Milan2mecha/mereni_efektivity/dokumentace a blokova schemata/LM317-efektivita.png

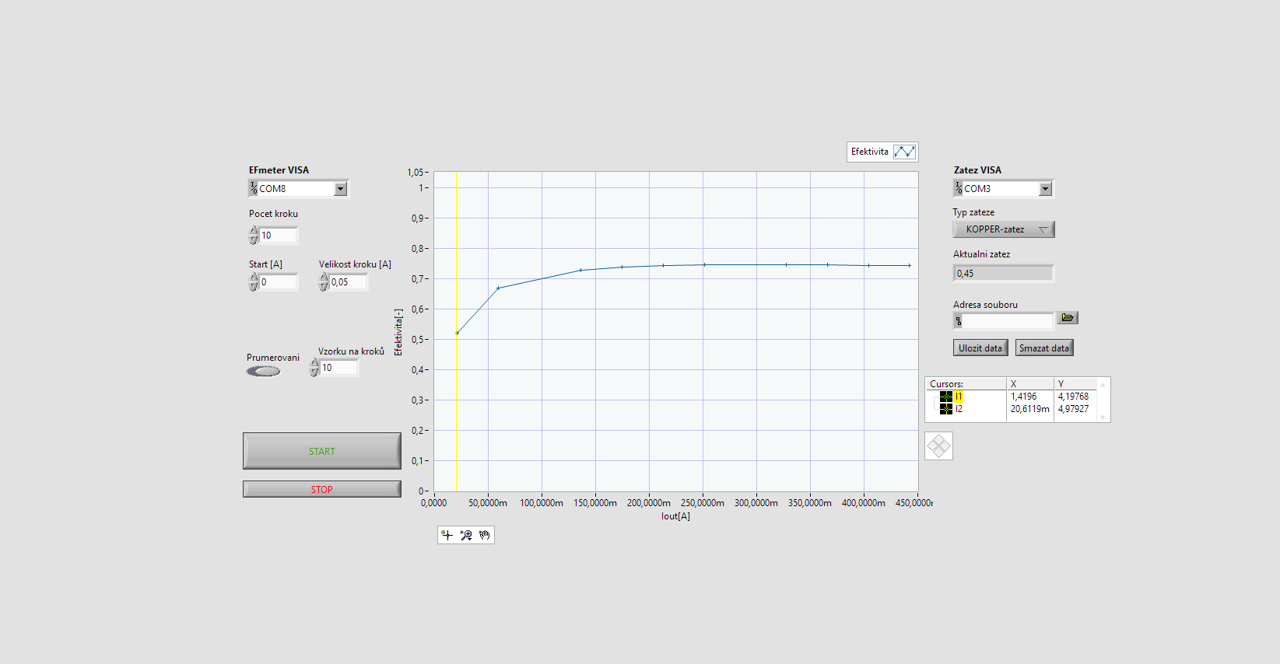
dokumentace a blokova schemata/LM317-efektivita.png
