Milan2mecha/mereni_efektivity/dokumentace a blokova schemata/LM317-zatezovaci.png

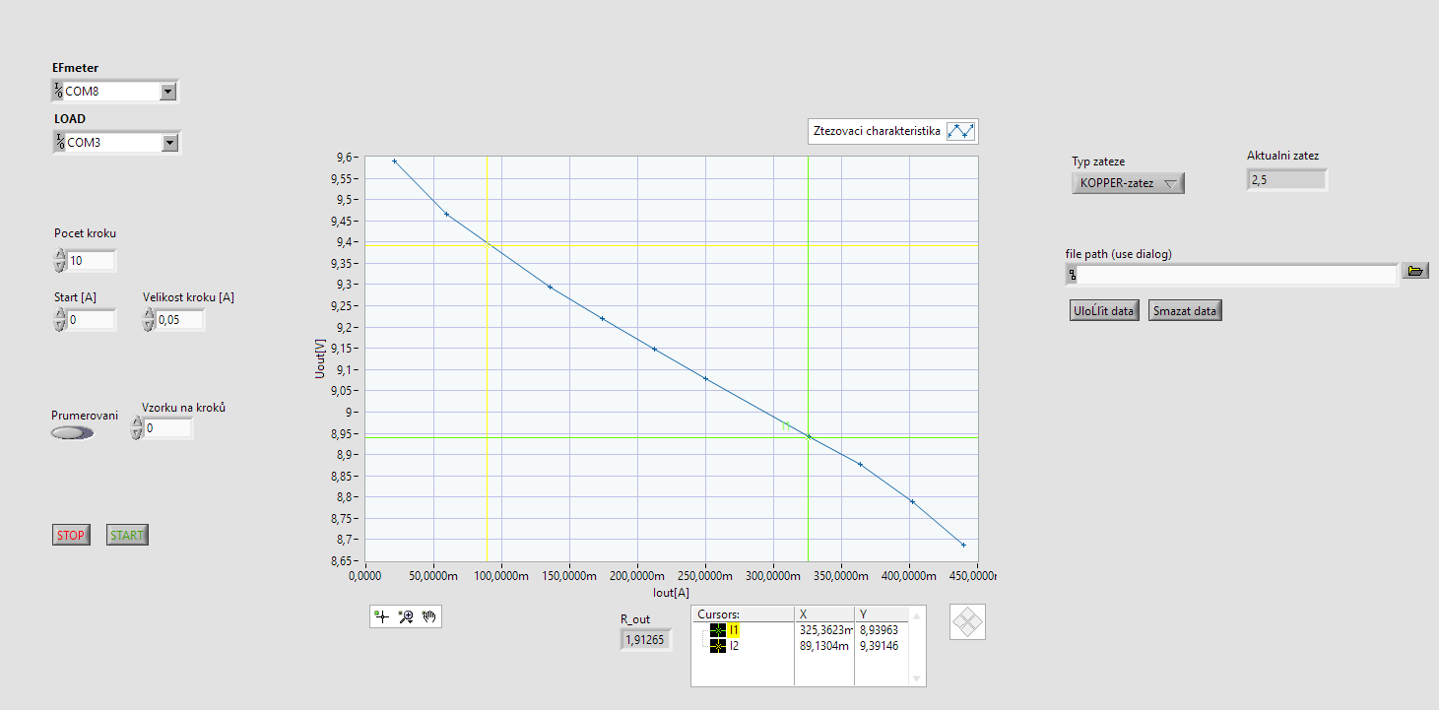
dokumentace a blokova schemata/LM317-zatezovaci.png
