Milan2mecha/mereni_efektivity/dokumentace a blokova schemata/Prevodni.png

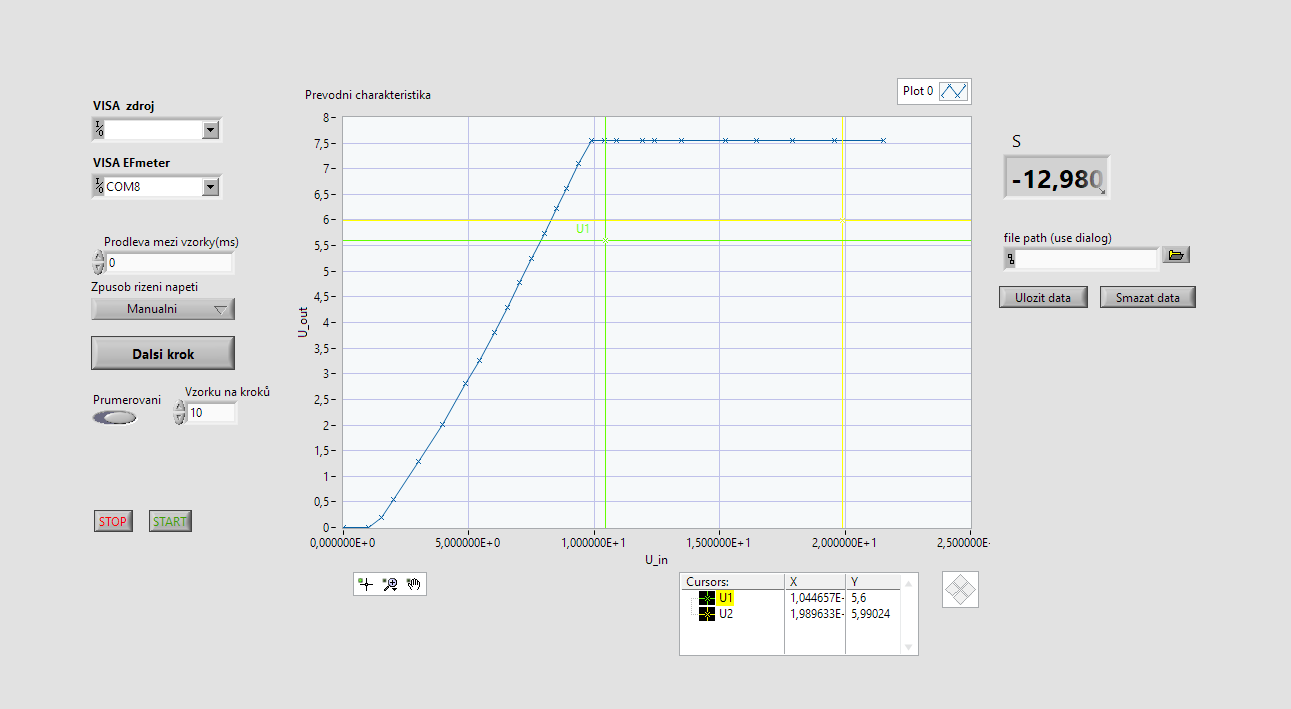
dokumentace a blokova schemata/Prevodni.png
