Milan2mecha/mereni_efektivity/dokumentace a blokova schemata/Prevodni_uprava.png

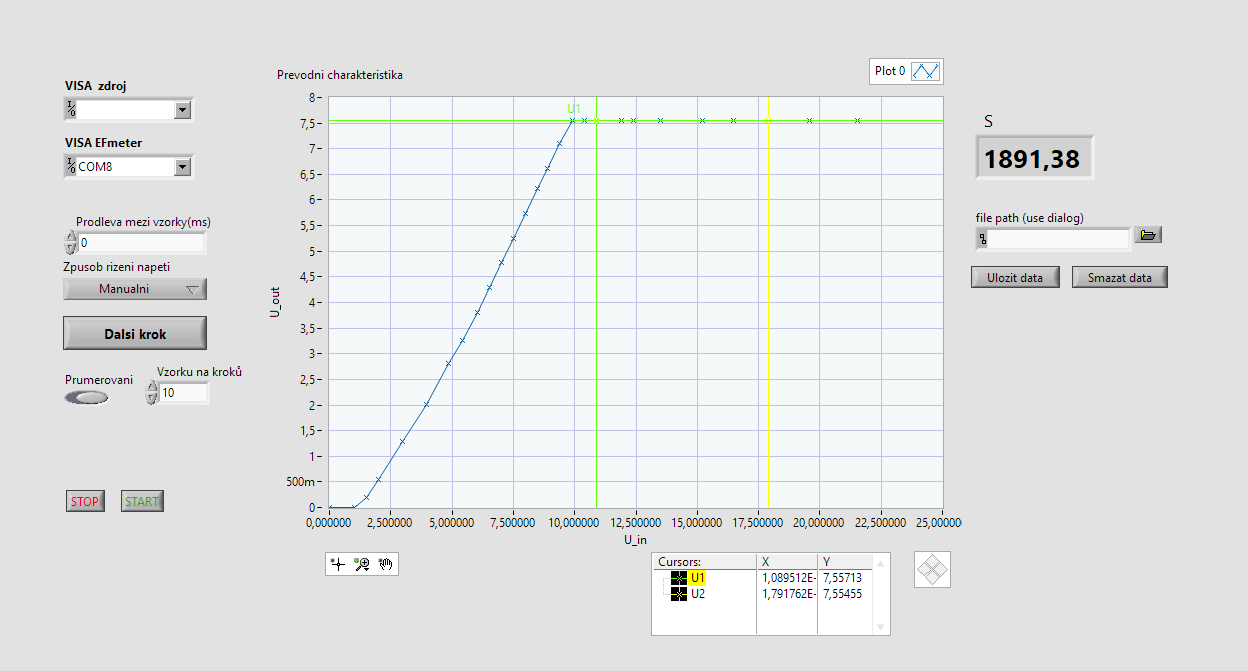
dokumentace a blokova schemata/Prevodni_uprava.png
