Milan2mecha/mereni_efektivity/dokumentace a blokova schemata/ukázka_DCIR.png

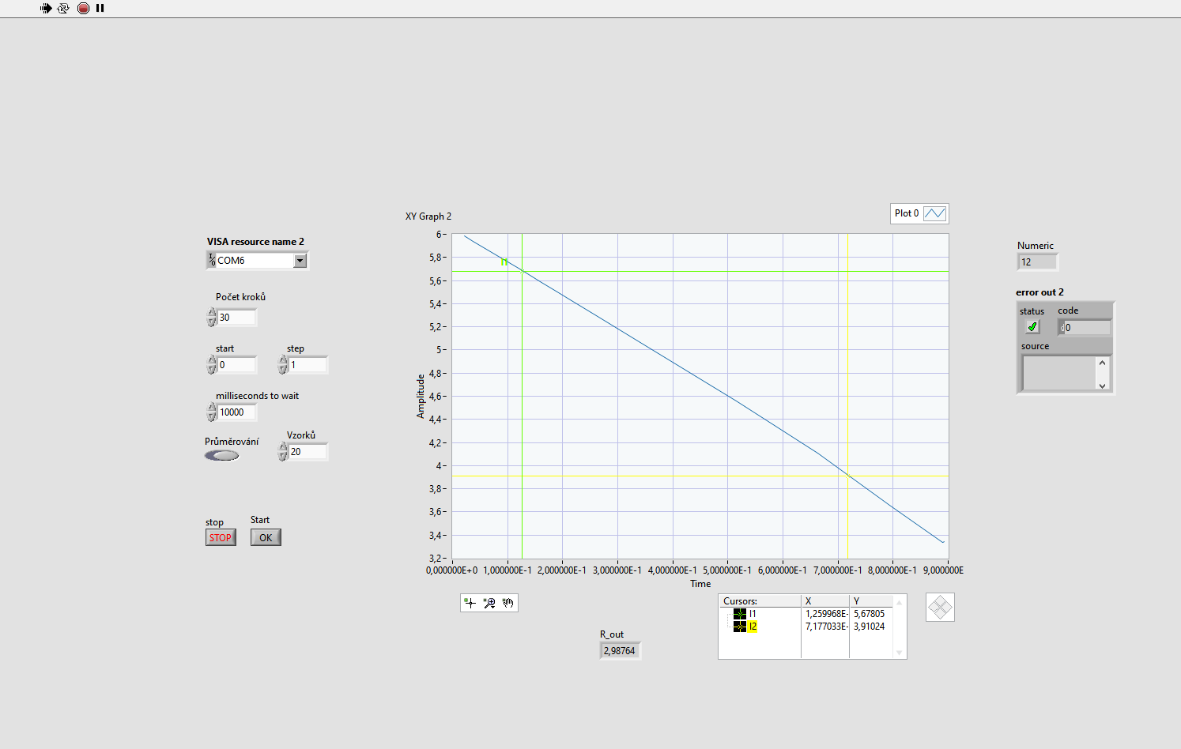
dokumentace a blokova schemata/ukázka_DCIR.png
