Milan2mecha/mereni_efektivity/HW/BP_deska_ochran_bottom.png

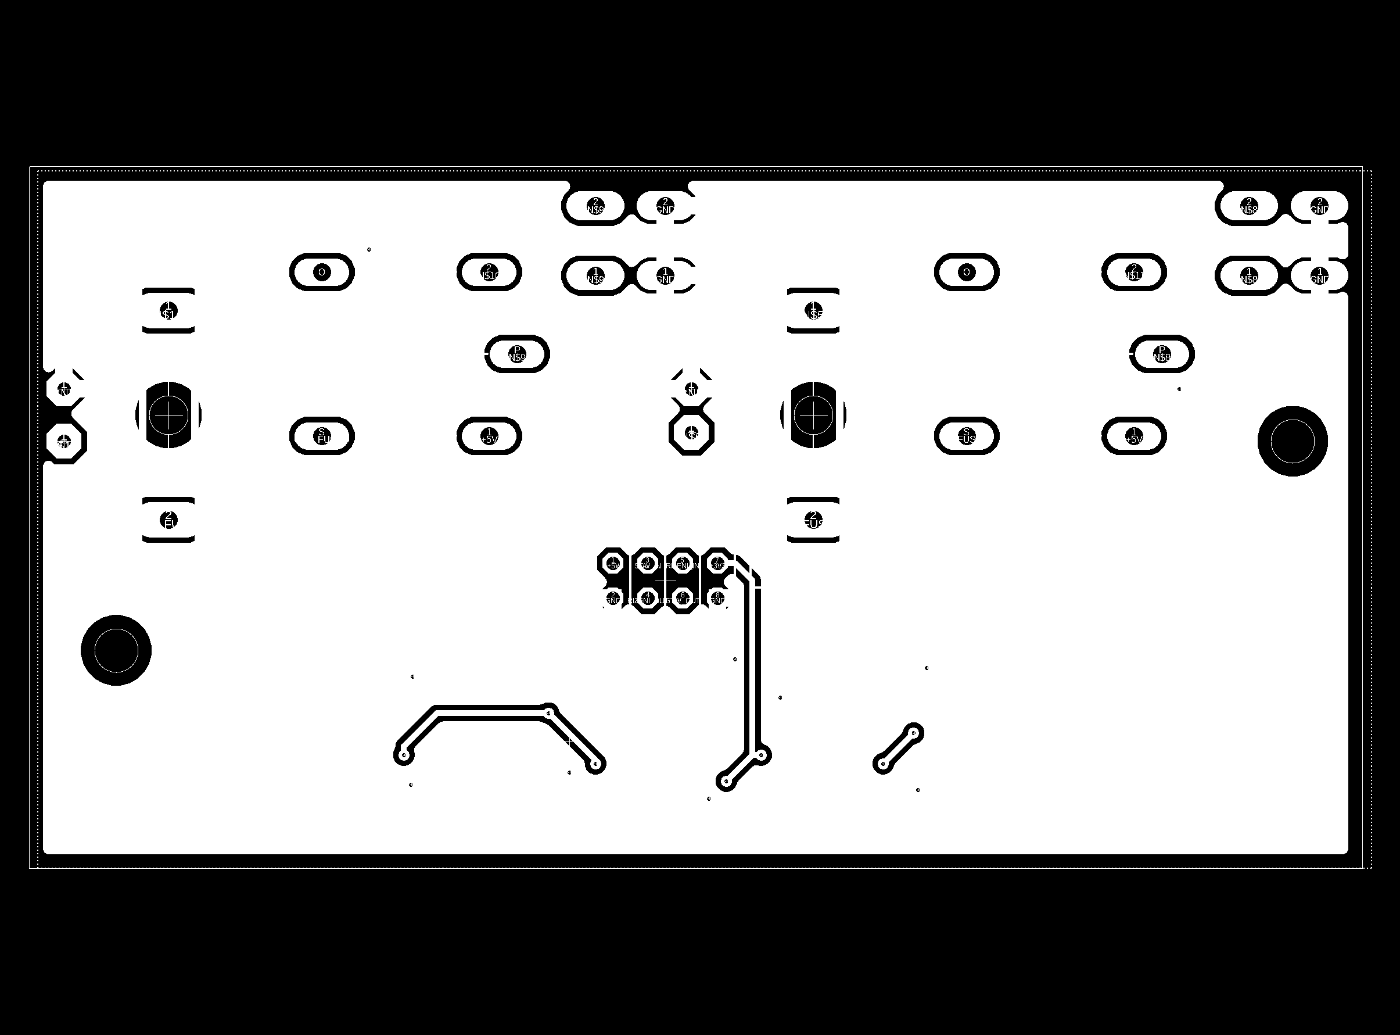
HW/BP_deska_ochran_bottom.png
