Milan2mecha/mereni_efektivity/HW/BP_deska_ochran_top.png

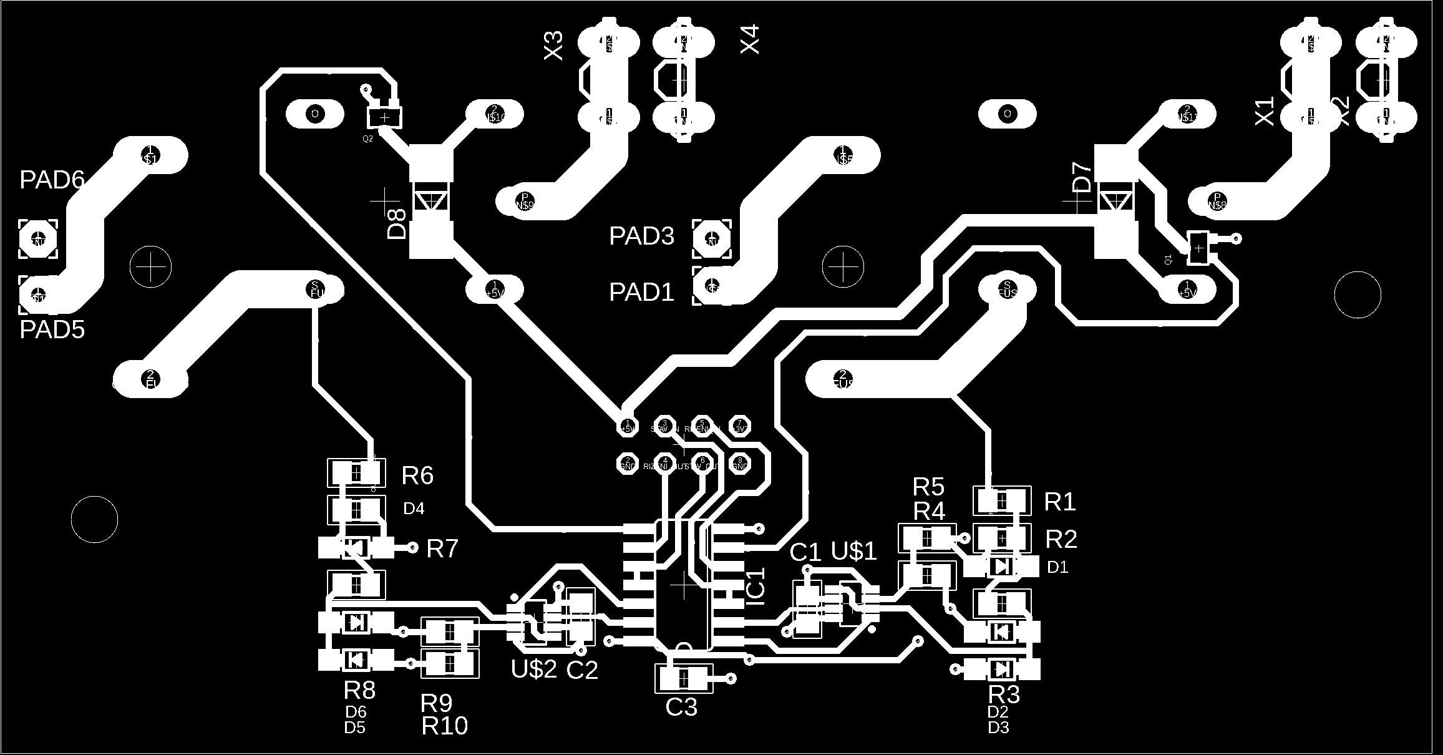
HW/BP_deska_ochran_top.png
