Milan2mecha/mereni_efektivity/HW/BP_devboard_bottom.png

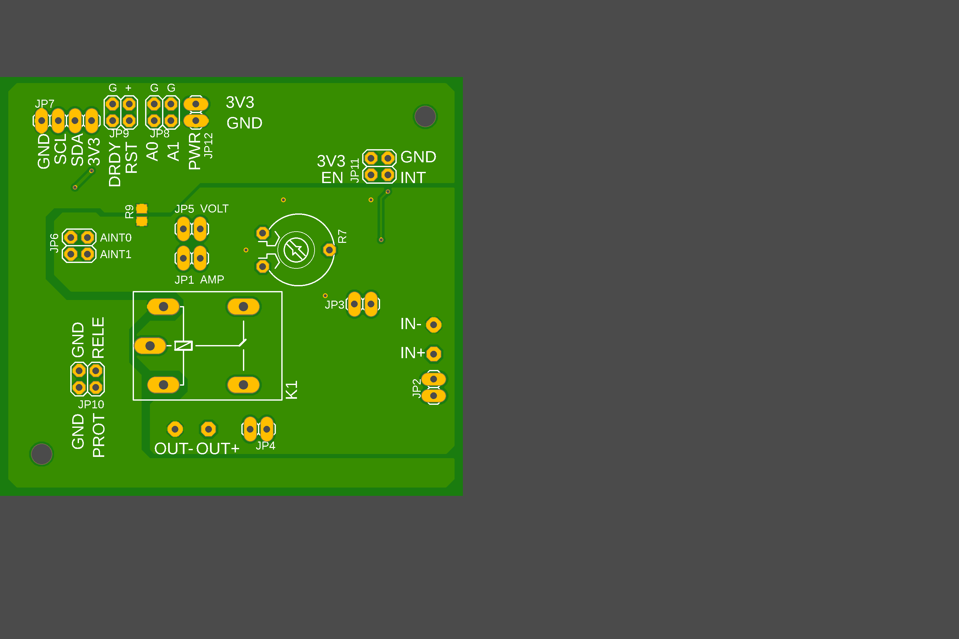
HW/BP_devboard_bottom.png
