Milan2mecha/mereni_efektivity/HW/BP_devboard_top.png

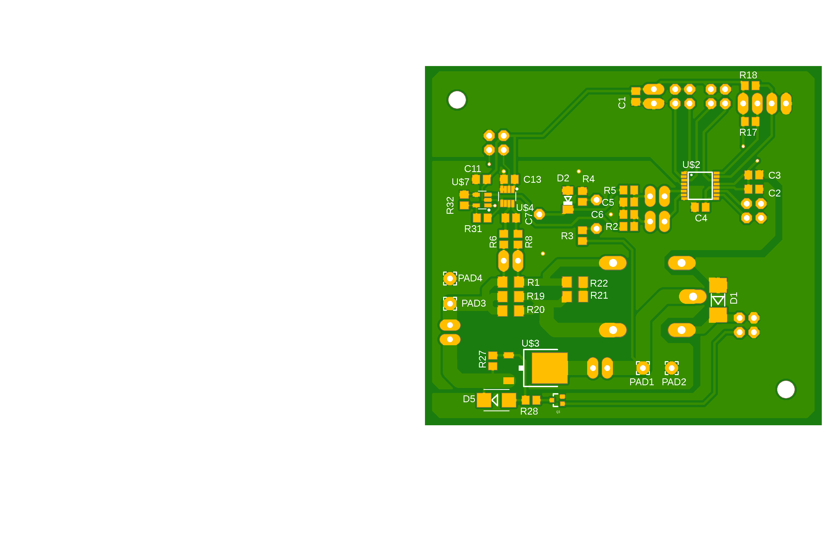
HW/BP_devboard_top.png
