Milan2mecha/mereni_efektivity/HW/BP_MCU_bottom.png

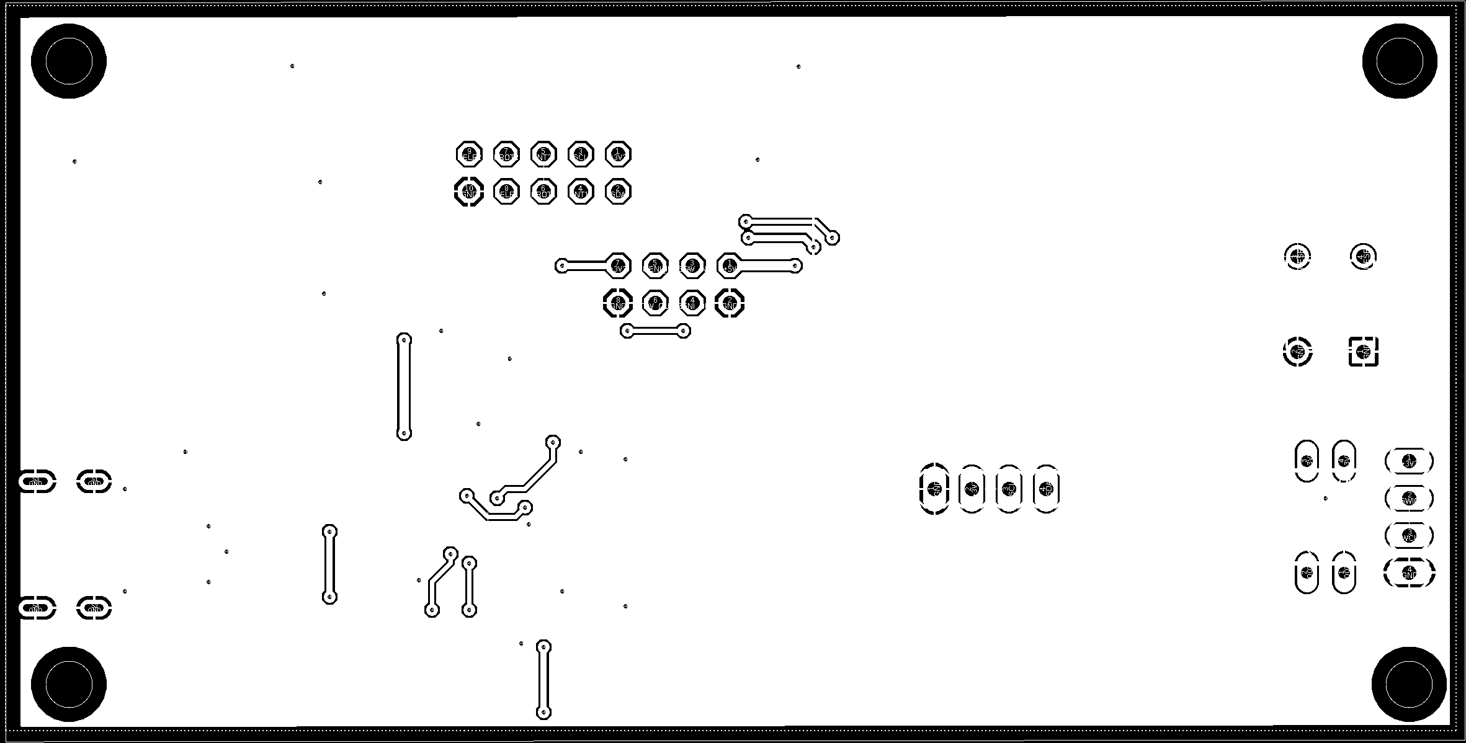
HW/BP_MCU_bottom.png
