Milan2mecha/mereni_efektivity/HW/BP_MCU_top.png

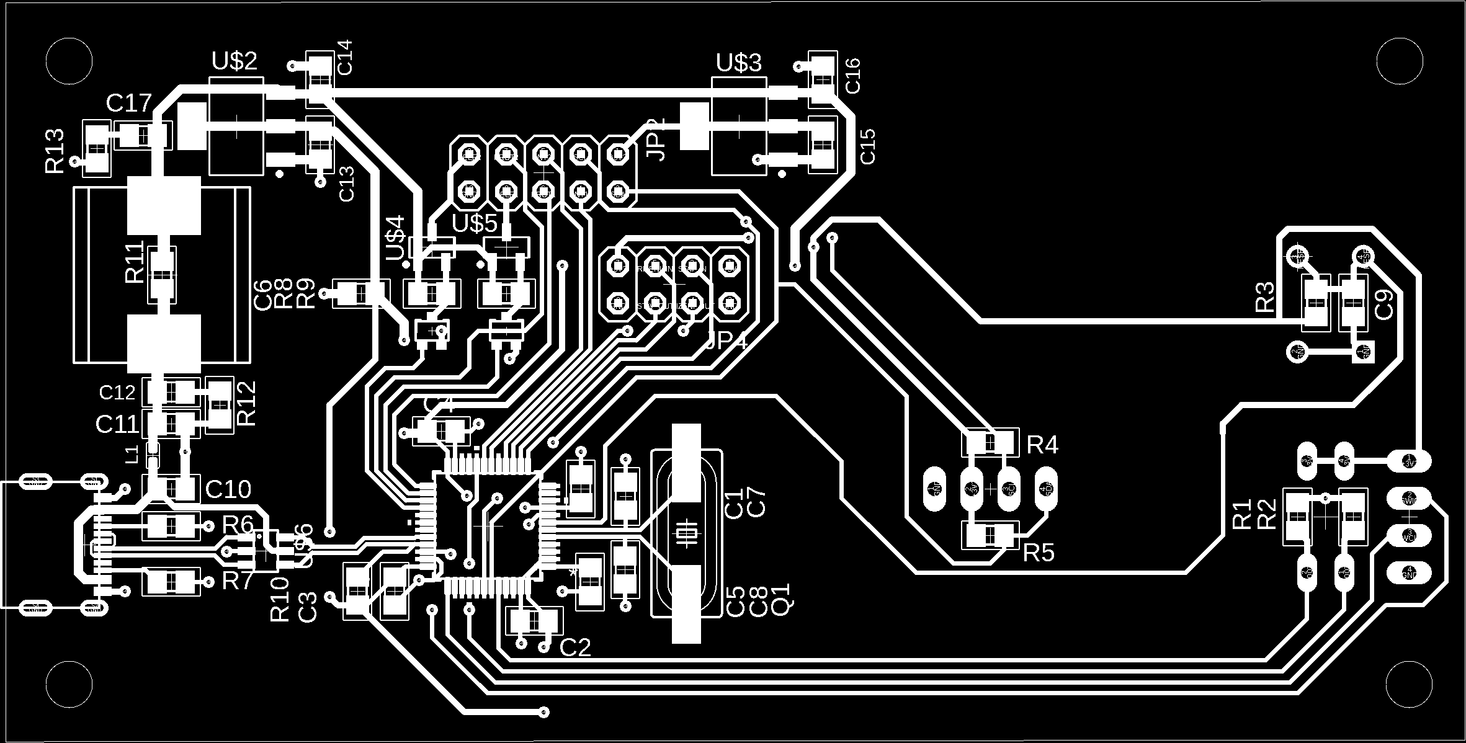
HW/BP_MCU_top.png
