Milan2mecha/mereni_efektivity/HW/BP_snimaci_cast_bottom.png

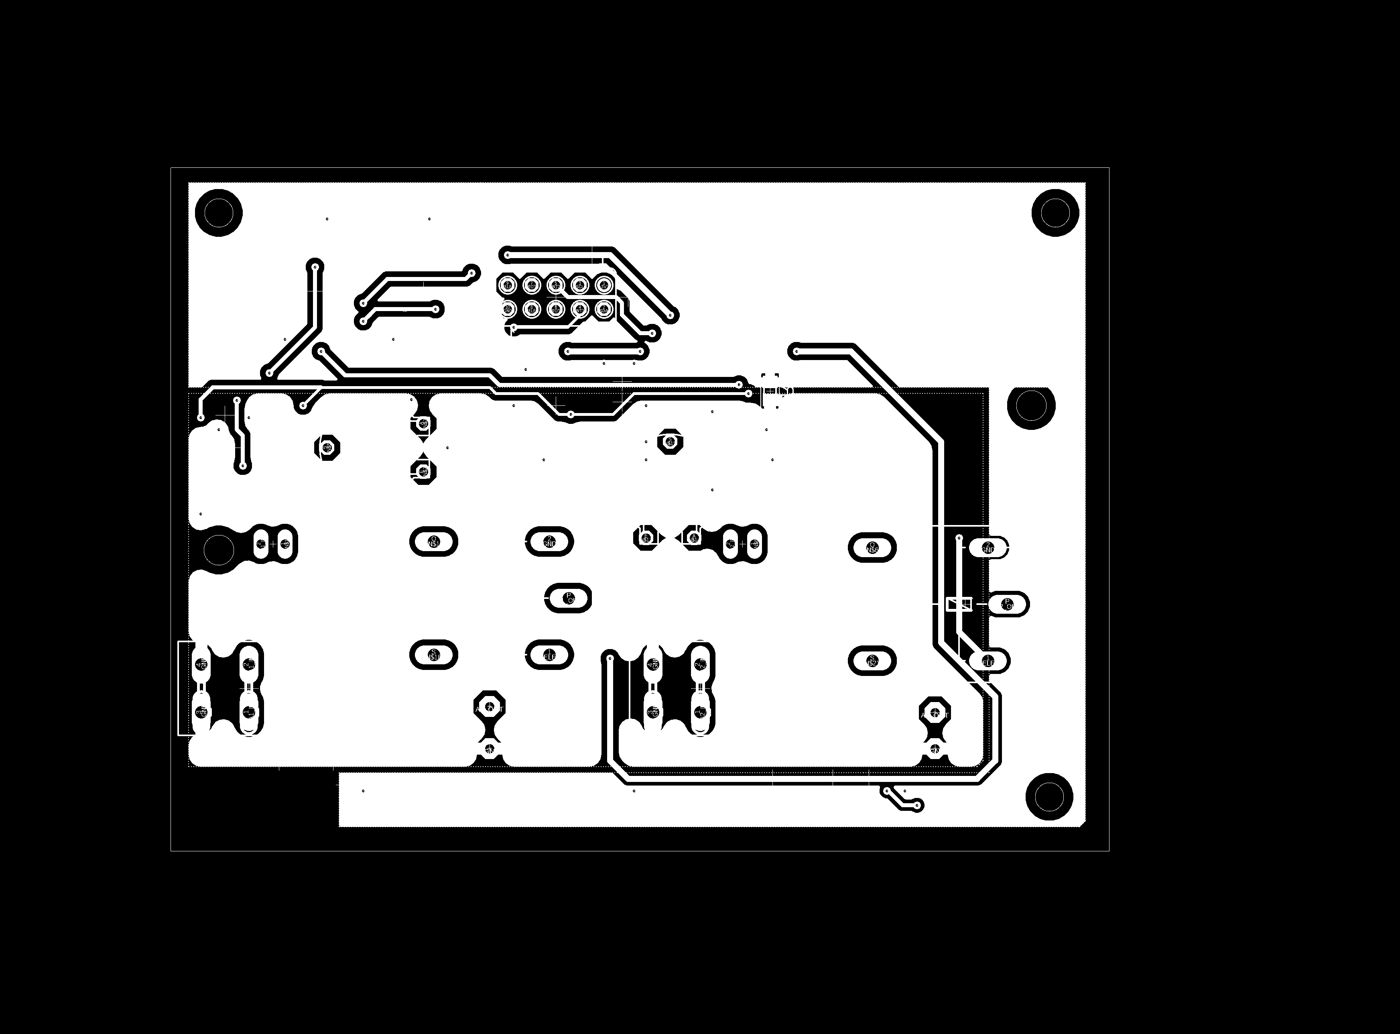
HW/BP_snimaci_cast_bottom.png
