Milan2mecha/mereni_efektivity/HW/BP_snimaci_cast_top.png

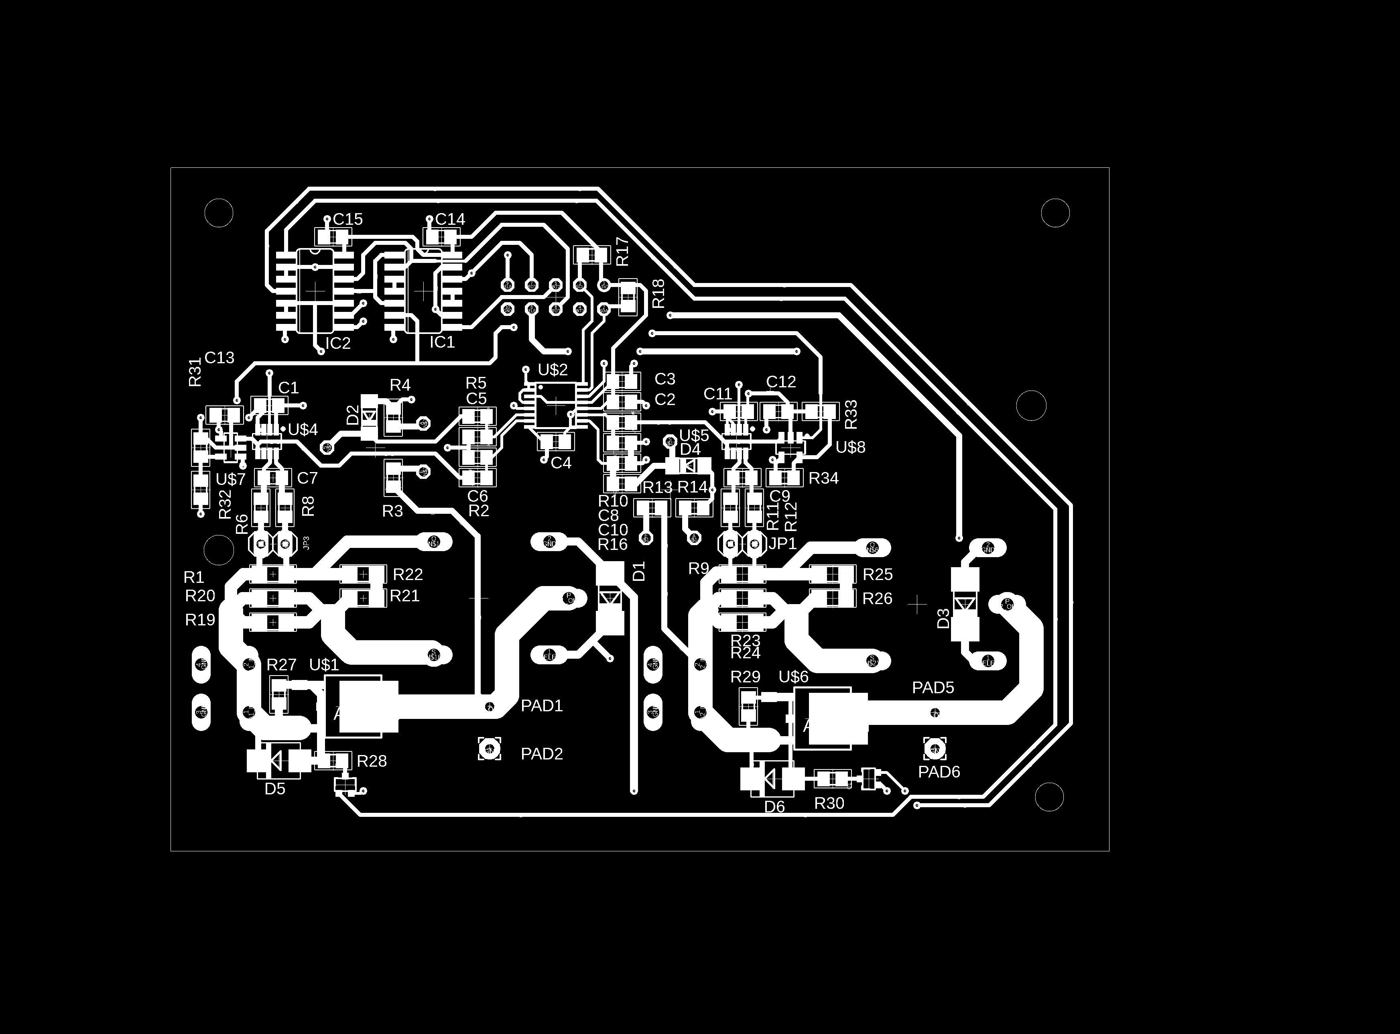
HW/BP_snimaci_cast_top.png
