Milan2mecha/mereni_efektivity/HW/spojeni_desek.png

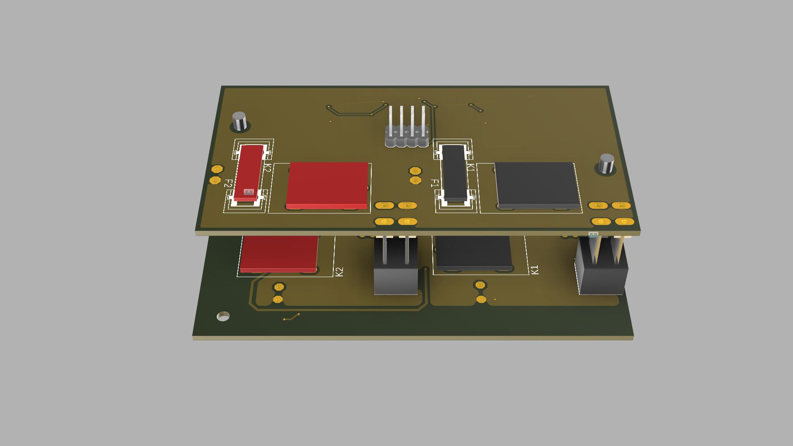
HW/spojeni_desek.png
