Milan2mecha/mereni_efektivity/HW/BP_devboard_sch.pdf

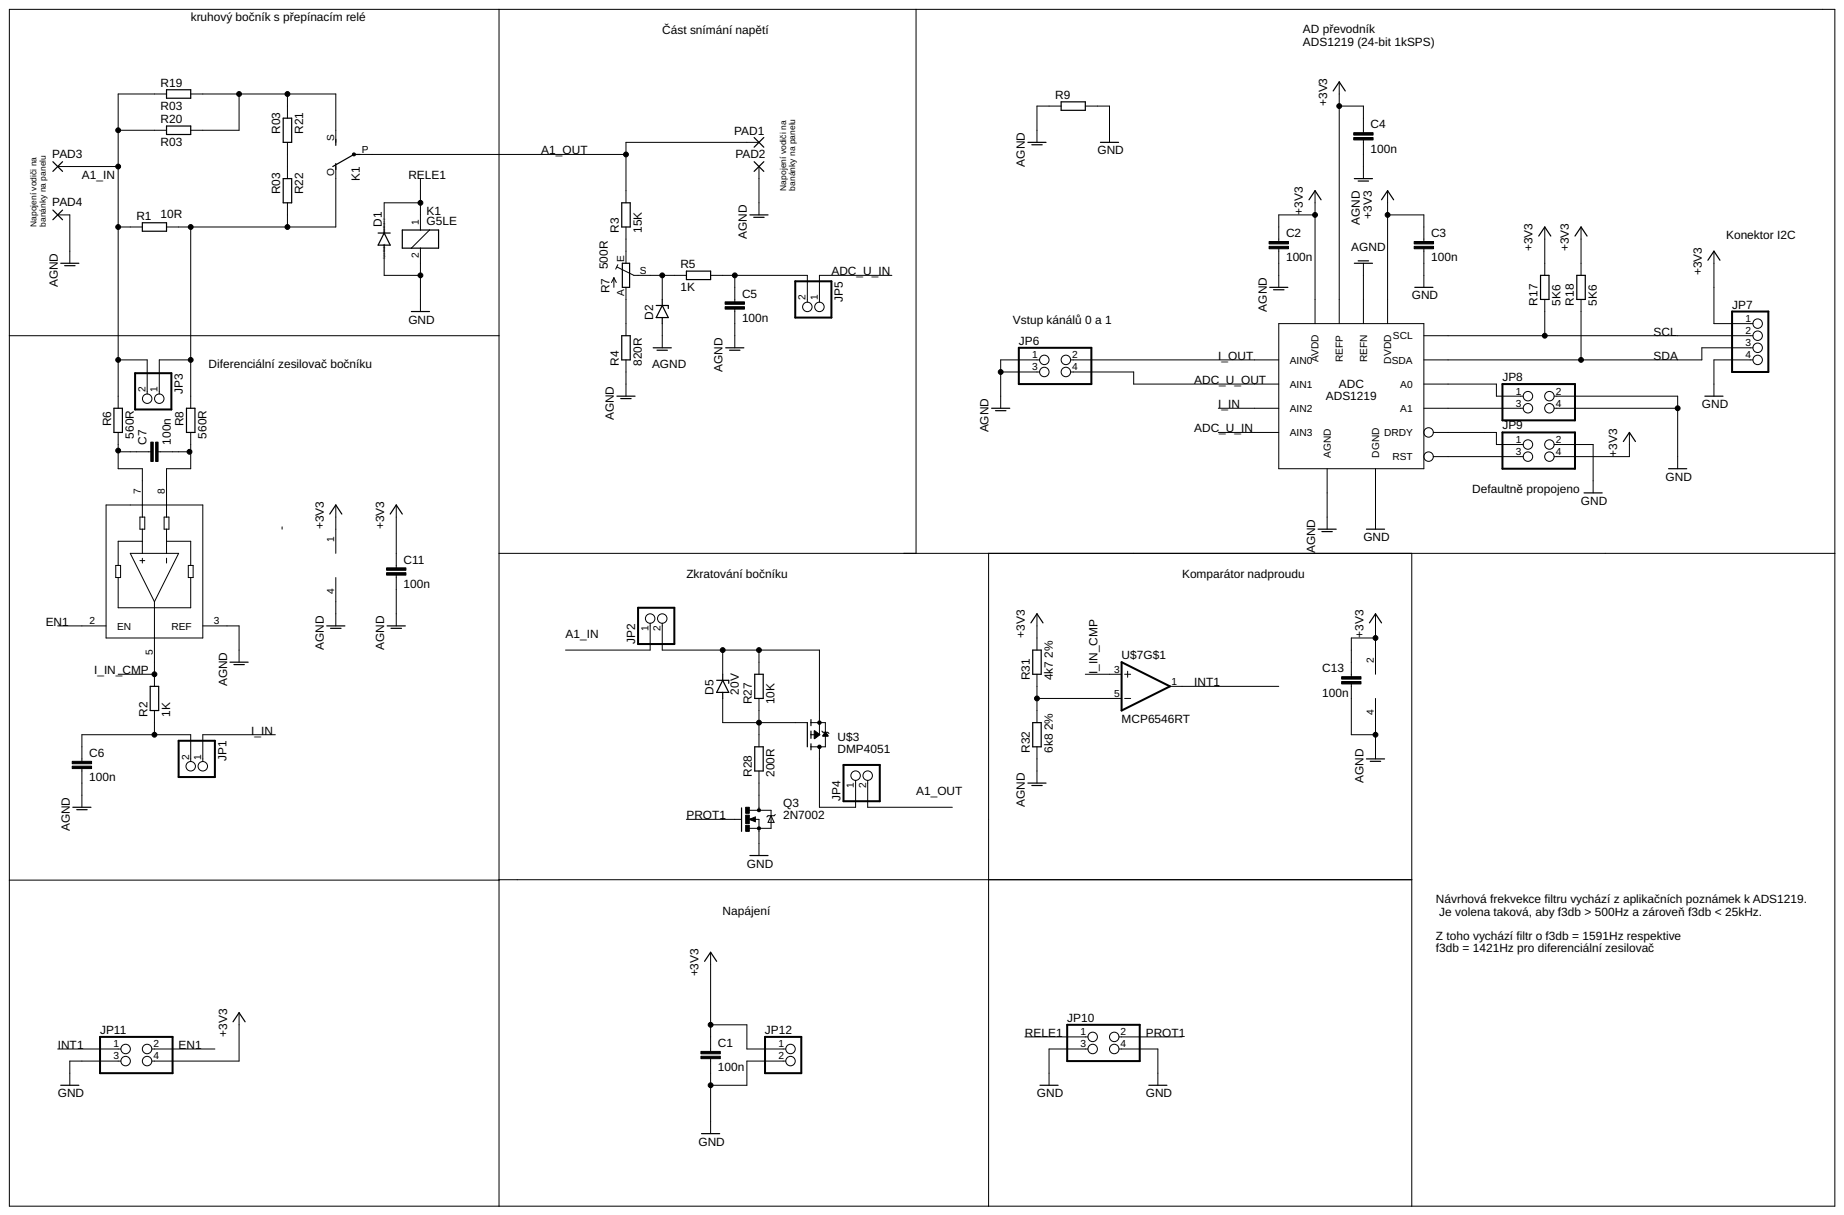
[picture p18: page 1]

kruhový bočník s přepínacím relé

Návrhová frekvekce filtru vychází z aplikačních poznámek k ADS1219. Je volena taková, aby f3db > 500Hz a zároveň f3db < 25kHz. Z toho vychází filtr o f3db = 1591Hz respektive
