Milan2mecha/mereni_efektivity/HW/BP_deska_ochran.pdf

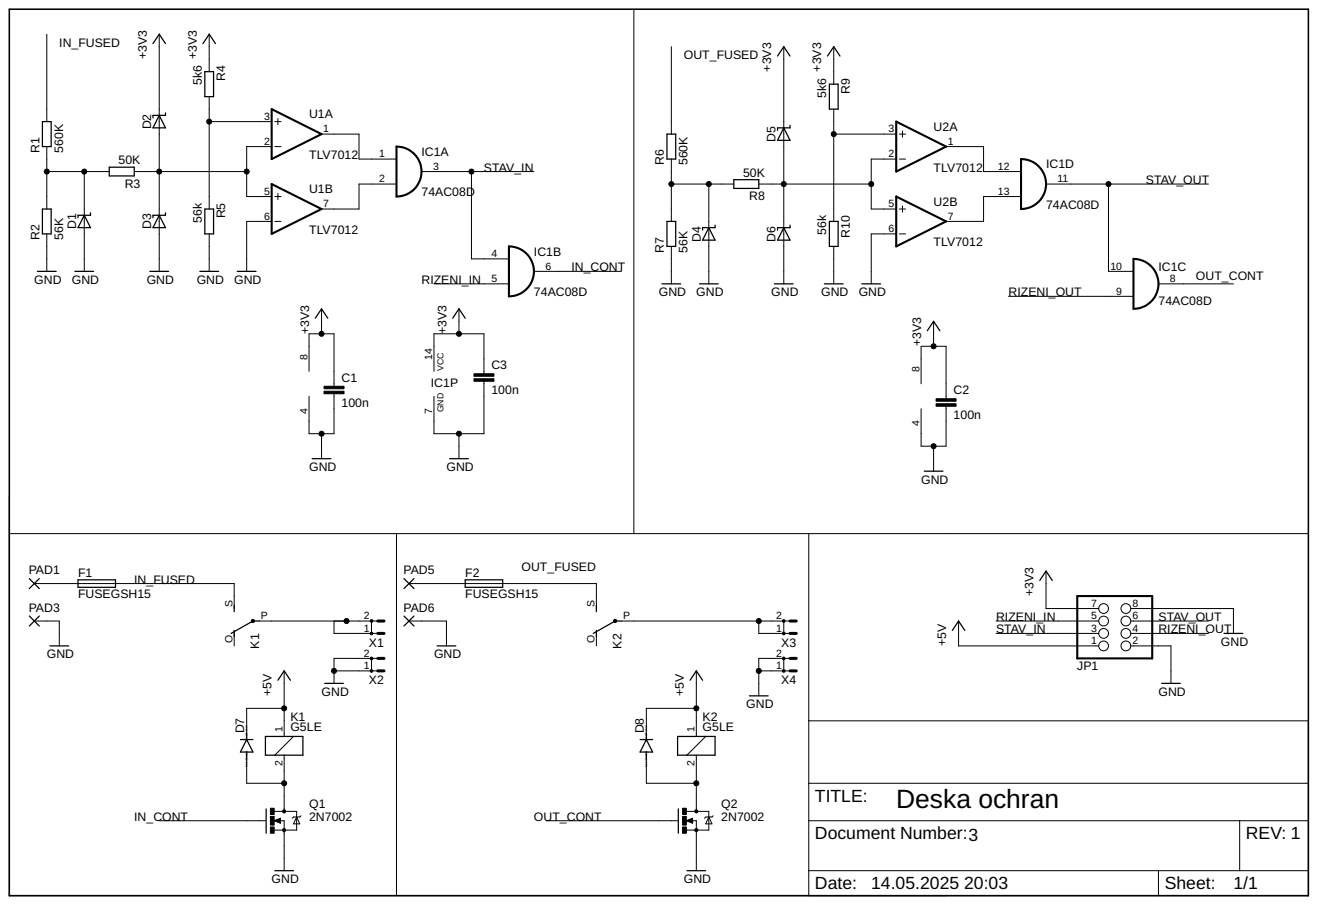
[picture p19: page 1]
