Milan2mecha/mereni_efektivity/HW/BP_deska_ochran_bottom.pdf

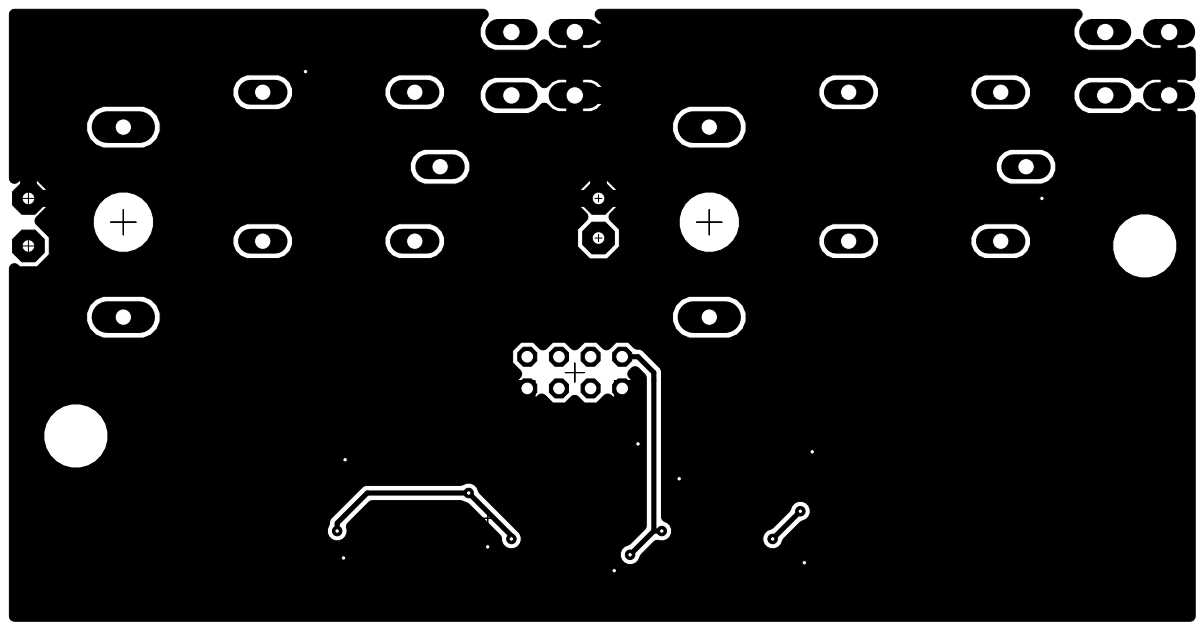
[picture p20: page 1]
