Milan2mecha/mereni_efektivity/HW/BP_deska_ochran_bottom_silk.pdf

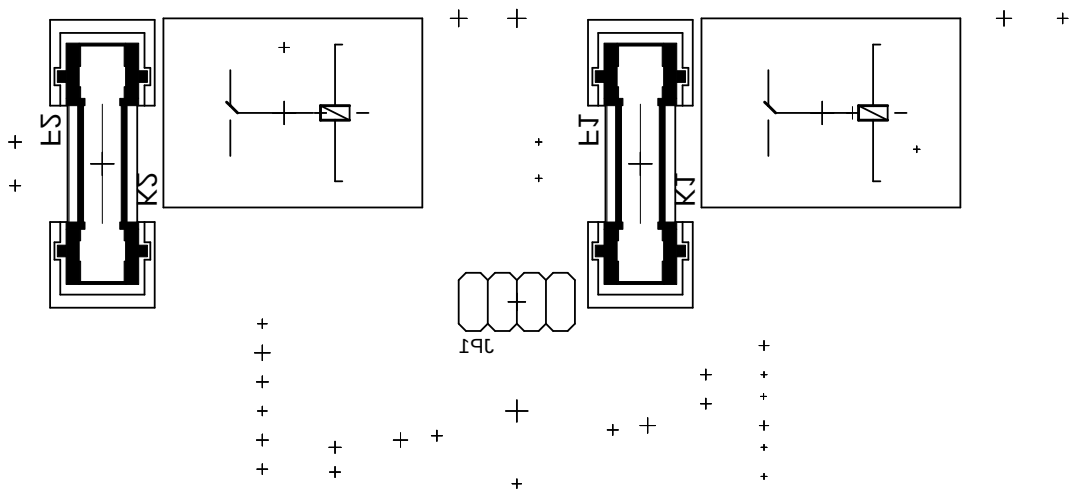
[picture p21: page 1]
