Milan2mecha/mereni_efektivity/HW/BP_deska_ochran_top.pdf

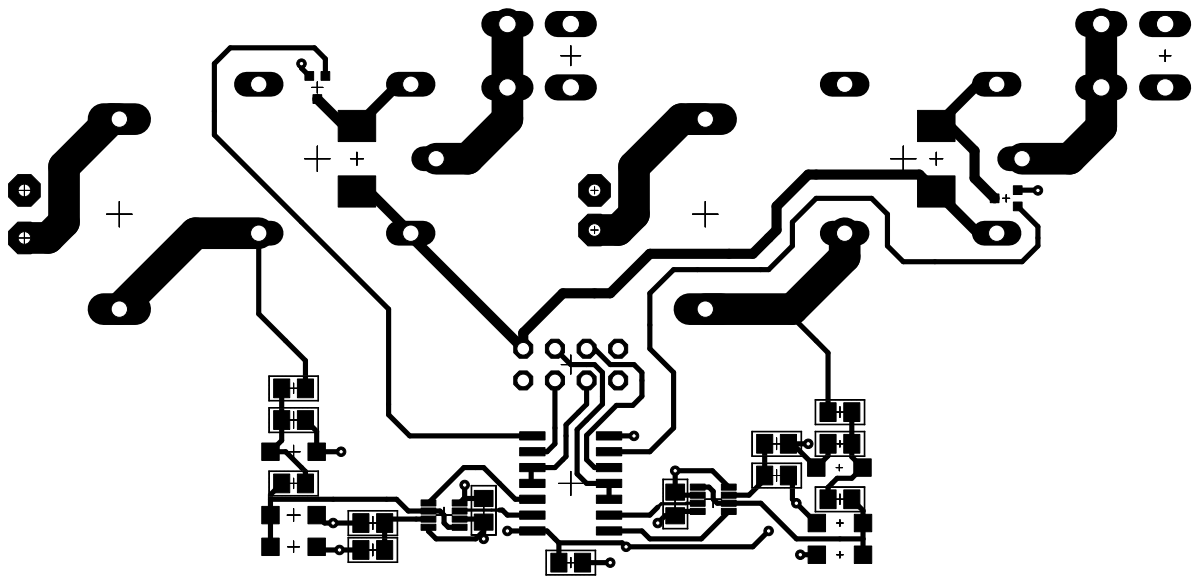
[picture p22: page 1]
