Milan2mecha/mereni_efektivity/HW/BP_deska_ochran_top_silk.pdf

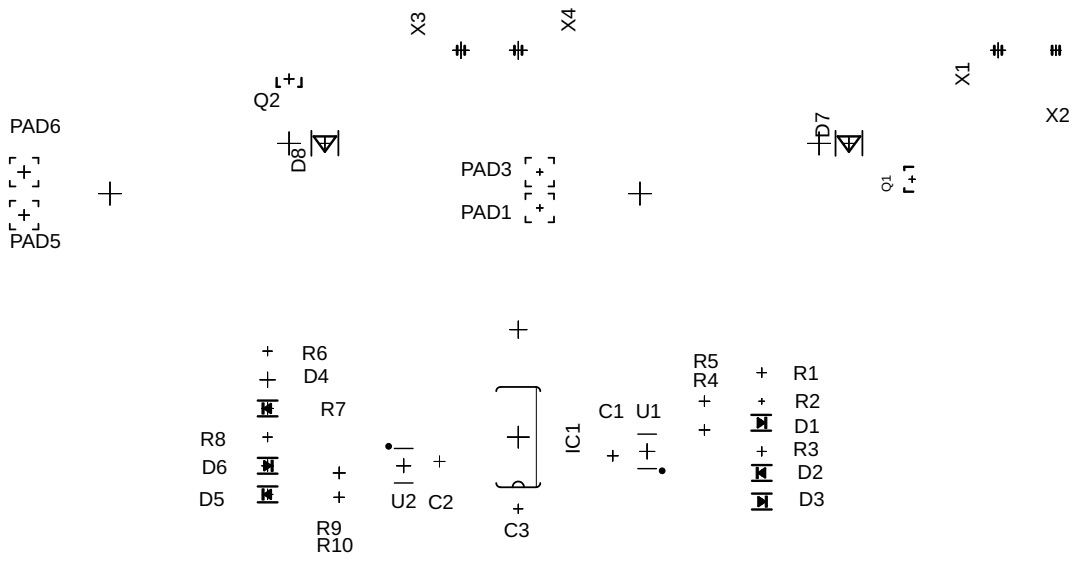
[picture p23: page 1]
