Milan2mecha/mereni_efektivity/HW/BP_MCU.pdf

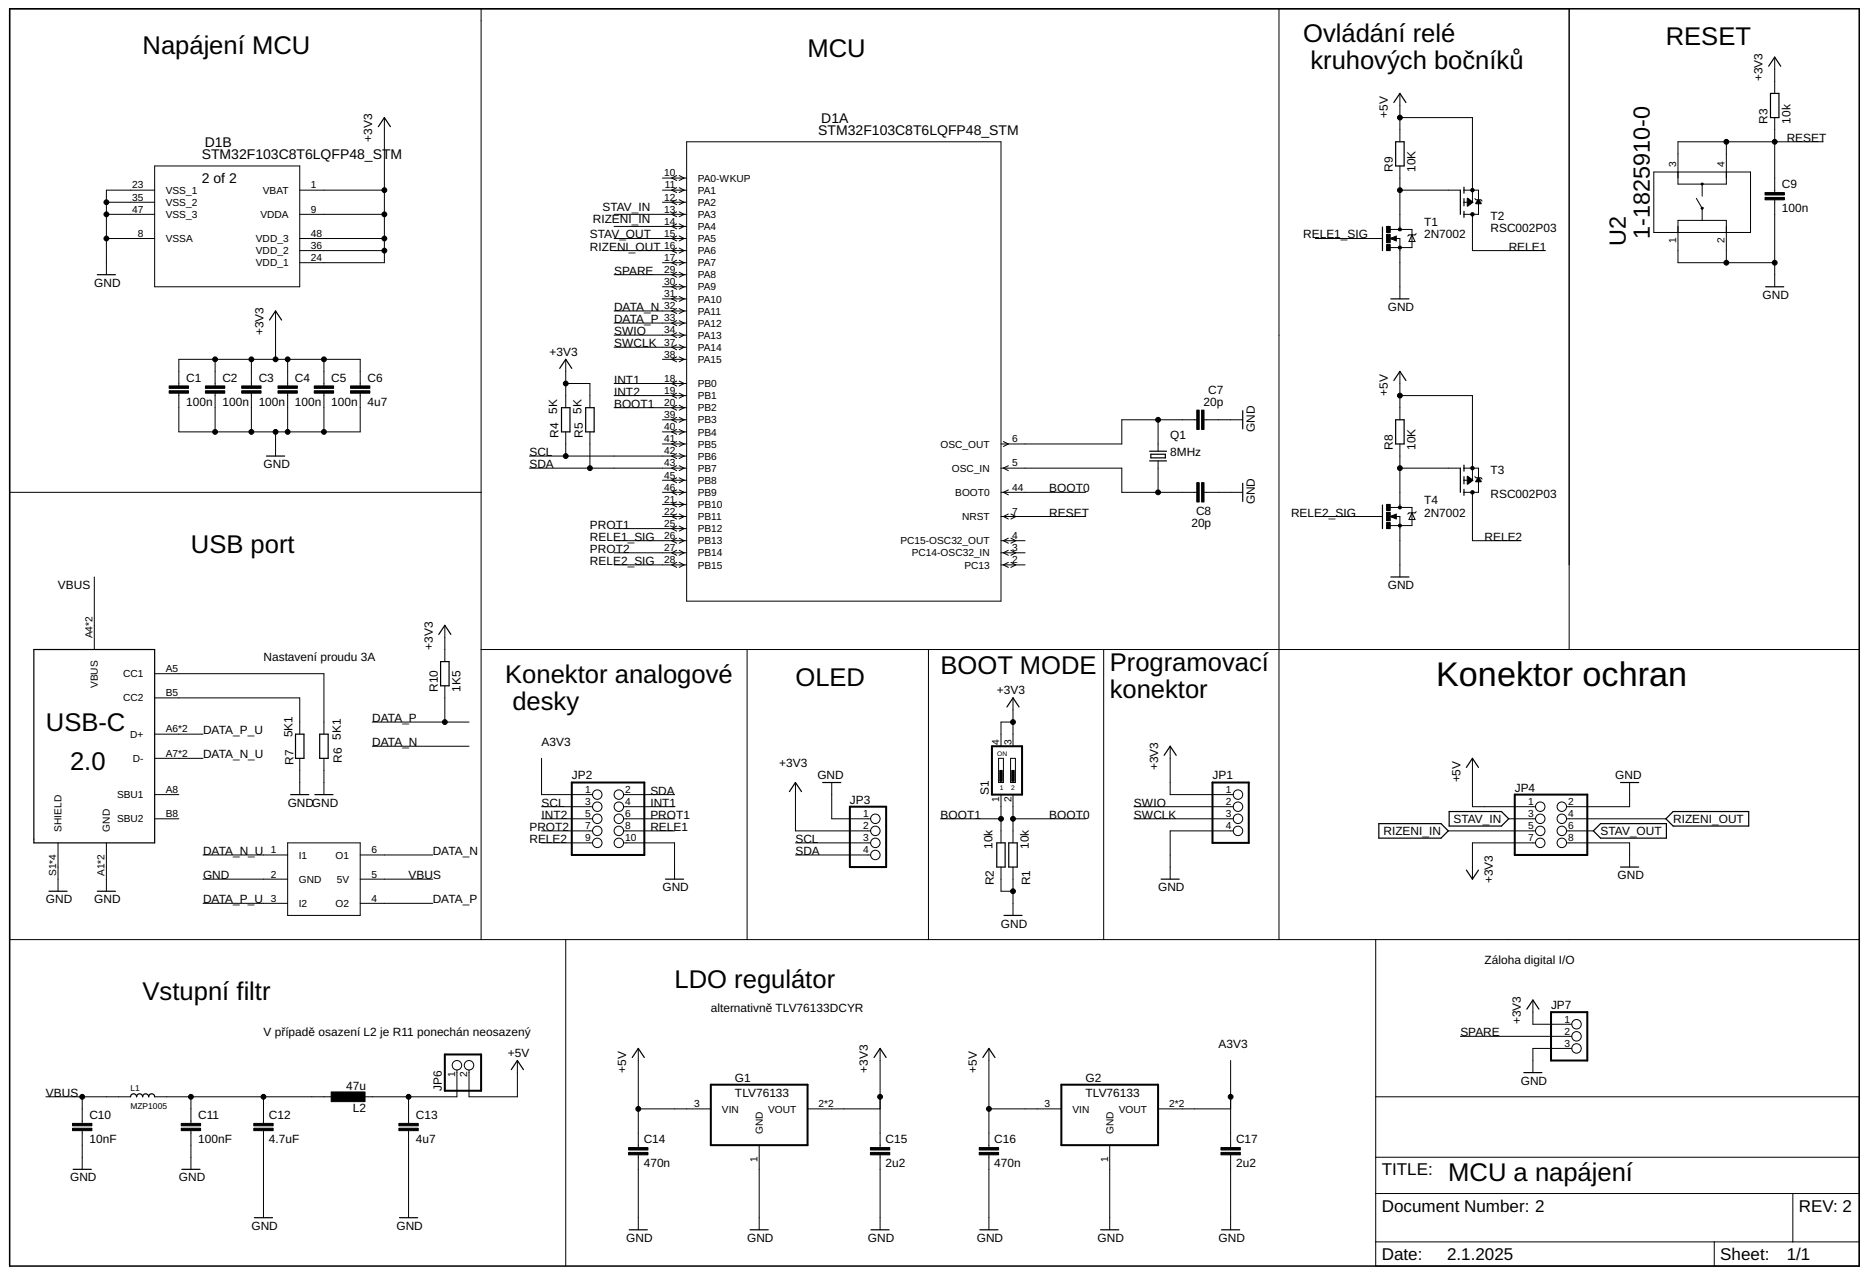
[picture p24: page 1]

V případě osazení L2 je R11 ponechán neosazený

Document Number: 2 | REV: 2

Date: 2.1.2025 | Sheet: 1/1
