Milan2mecha/mereni_efektivity/HW/BP_MCU_bottom.pdf

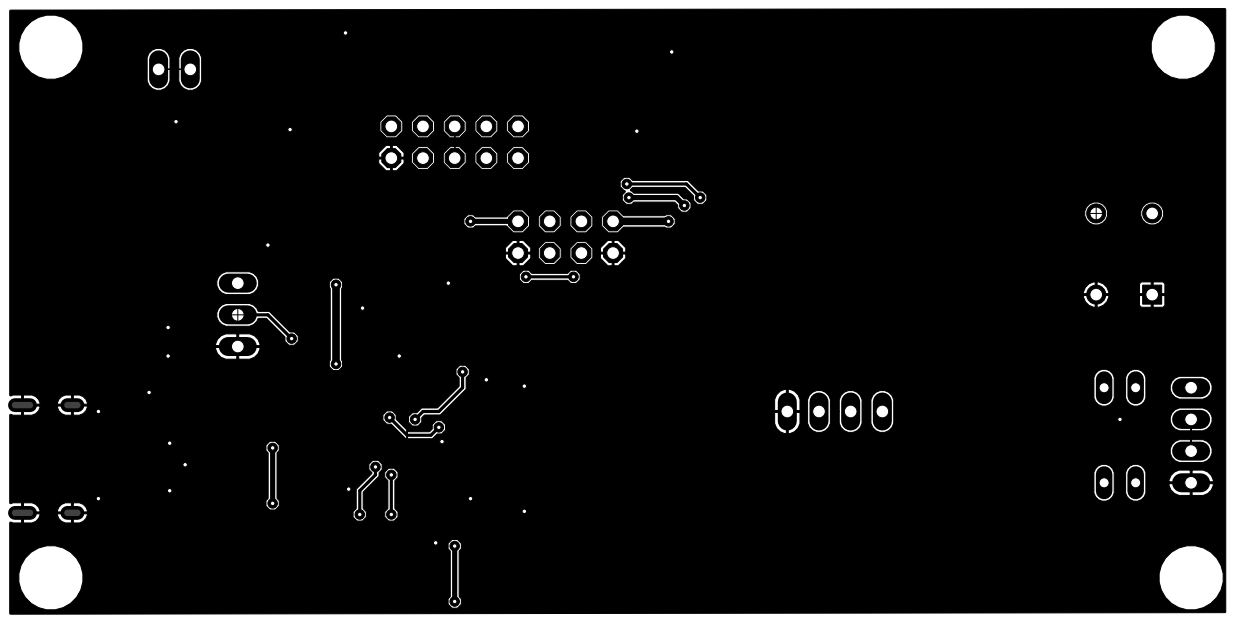
[picture p25: page 1]
