Milan2mecha/mereni_efektivity/HW/BP_MCU_bottom_silk.pdf

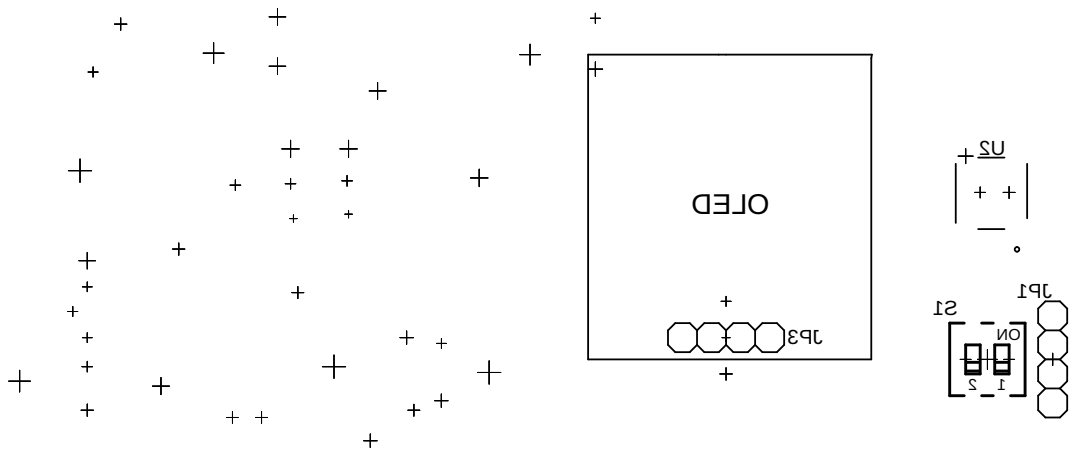
[picture p26: page 1]
