Milan2mecha/mereni_efektivity/HW/BP_MCU_top.pdf

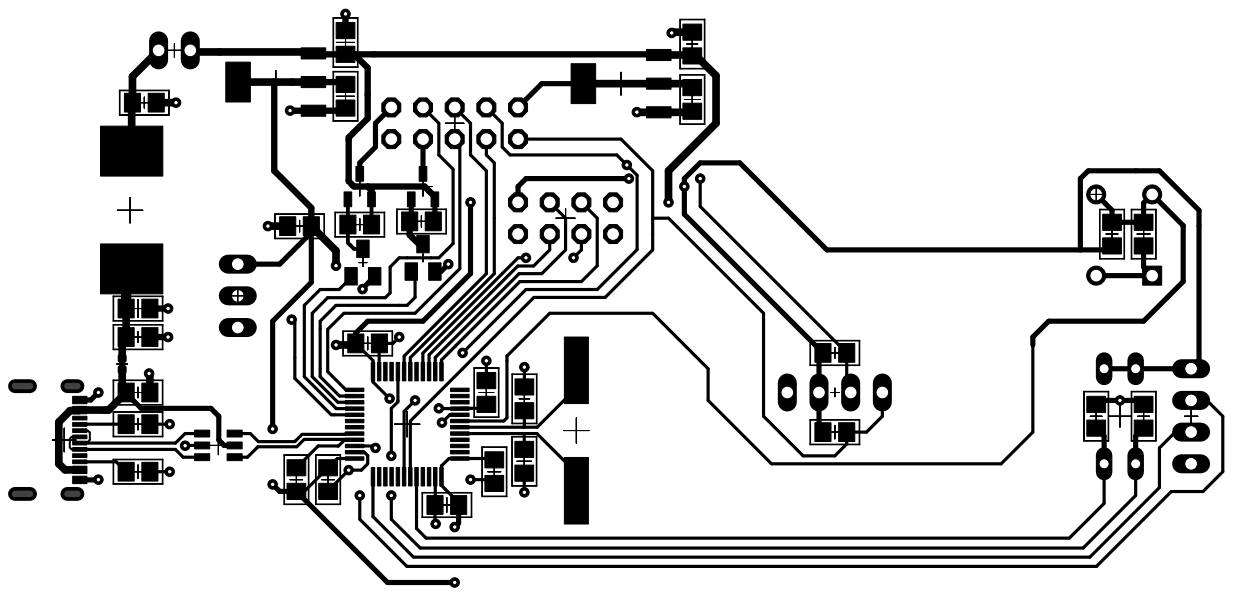
[picture p27: page 1]
