Milan2mecha/mereni_efektivity/HW/BP_MCU_top_silk.pdf

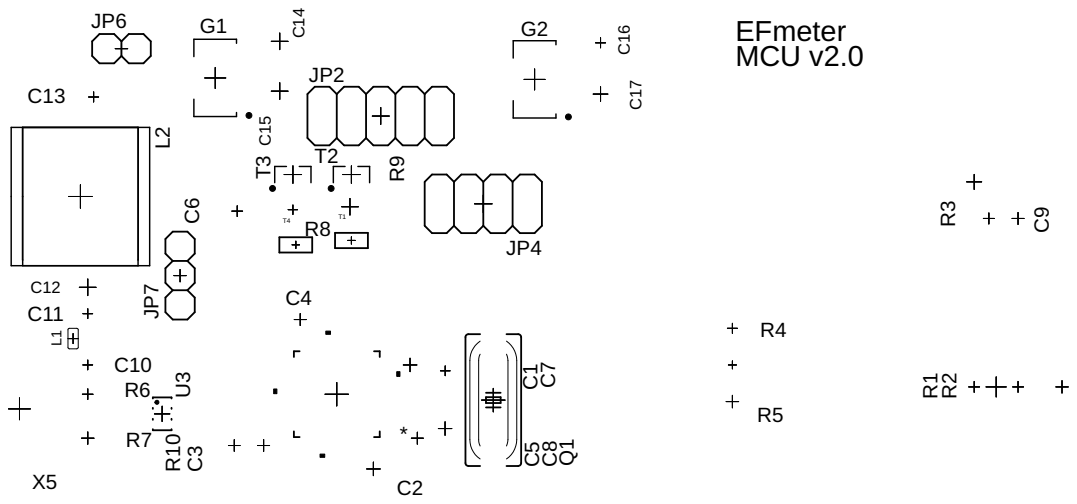
[picture p28: page 1]
