Milan2mecha/mereni_efektivity/HW/BP_snimaci_cast.pdf

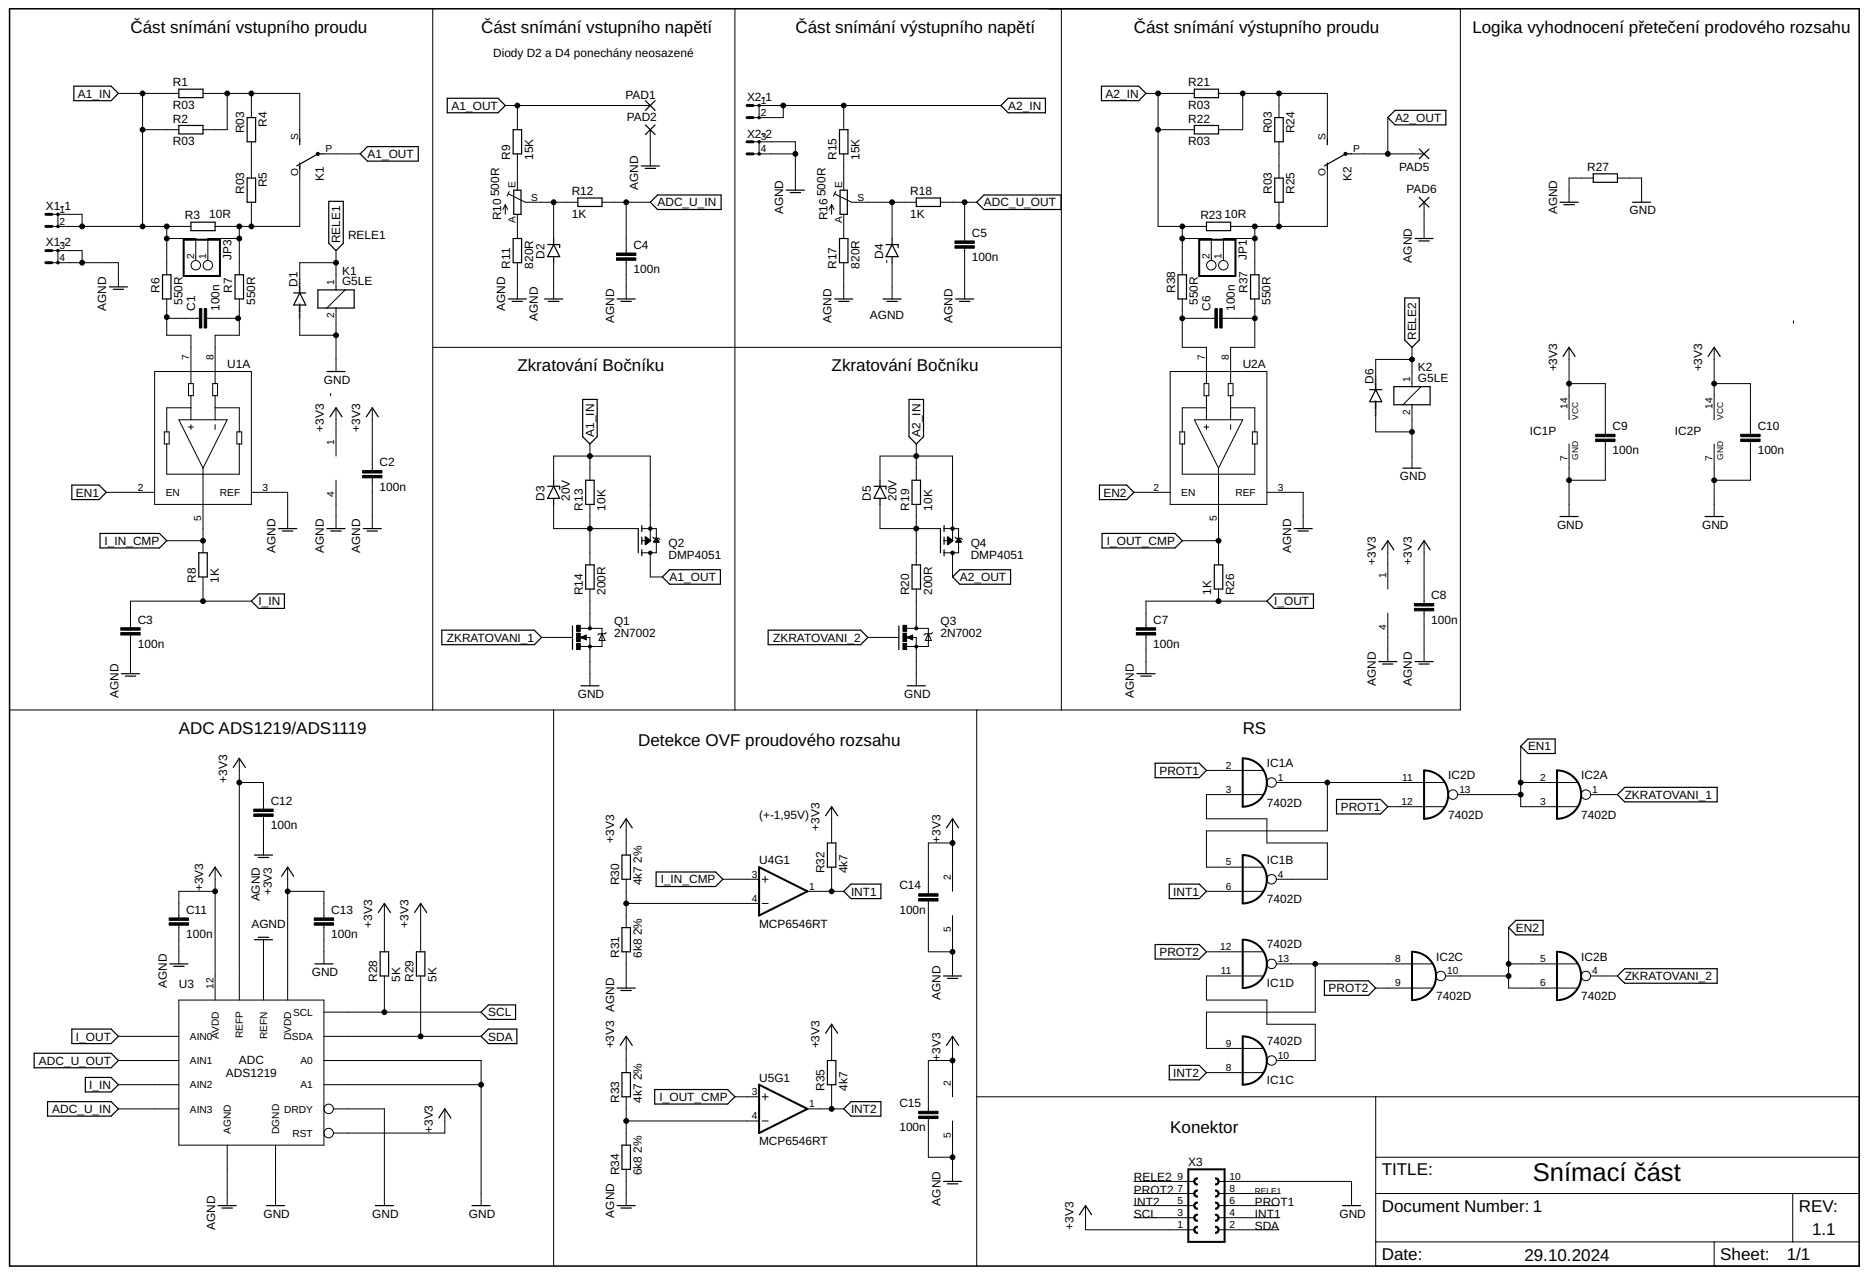
[picture p29: page 1]

Logika vyhodnocení přetečení prodového rozsahu

Detekce OVF proudového rozsahu
