Milan2mecha/mereni_efektivity/LTspice/protection_alternativa.asc

D1: schottky; BAT46WJ
D2: schottky; BAT46WJ
D3: schottky; BAT46WJ
R1: res; 10K
R2: res; 150K
R3: res; 500k
R4: res; 30K
R5: res; 3K
R6: res; 10K
R7: res; 50k
U2: TLV7011
U3: TLV7011
V1: voltage; 0v
V2: voltage; 3.3V
Named nets: 0
.dc V1 -100 100 0.1
Window detektor s over the rail ochranou
