Milan2mecha/mereni_efektivity/LTspice/filtr.asc

C1: cap; 100n; Rser=0.05
C3: cap; 470n; Rser=0.05
C4: cap; 4µ7; Rser=0.05
C6: cap; 10n
L1: FerriteBead; 150n; Ipk=3 Rser=0.025 Rpar=35 Cpar=850f mfg="Würth Elektronik" pn="742792609 WE-CBF 0603"
L2: ind; 47µ; Rser=0.067 Cpar=50p
R1: res; 3R3
R2: res; 1R
R3: res; 1R
U1: LT1117-3.3
U2: BZX84C3V3LY; GRM21BR71C475KE51_DC0V_25degC
U3: BZX84C3V3LY; GRM21BR71C475KE51_DC0V_25degC
V1: voltage; 5V; AC 1V 0
Named nets: 0
.ac dec 50 10 100000000
.include /home/milan/Documents/mereni_efektivity/LTspice/GRM21BR71C475KE51_DC0V_25degC.mod
