Milan2mecha/mereni_efektivity/LTspice/zkratovani_bocniku.asc

D1: zener; UDZV20B
M1: nmos; SP8K24
M2: pmos; FDS4685
R1: res; 10K
R2: res; 200
R3: res; 0.6
V1: voltage; PULSE(0 3.3 0 0.001 0.001 .5 2)
V2: voltage; 3
Named nets: 0
.tran 20
