Milan2mecha/mereni_efektivity/HW/BP_protection_board.brd

## EAGLE design HW/BP_protection_board.brd (2024-12-08)

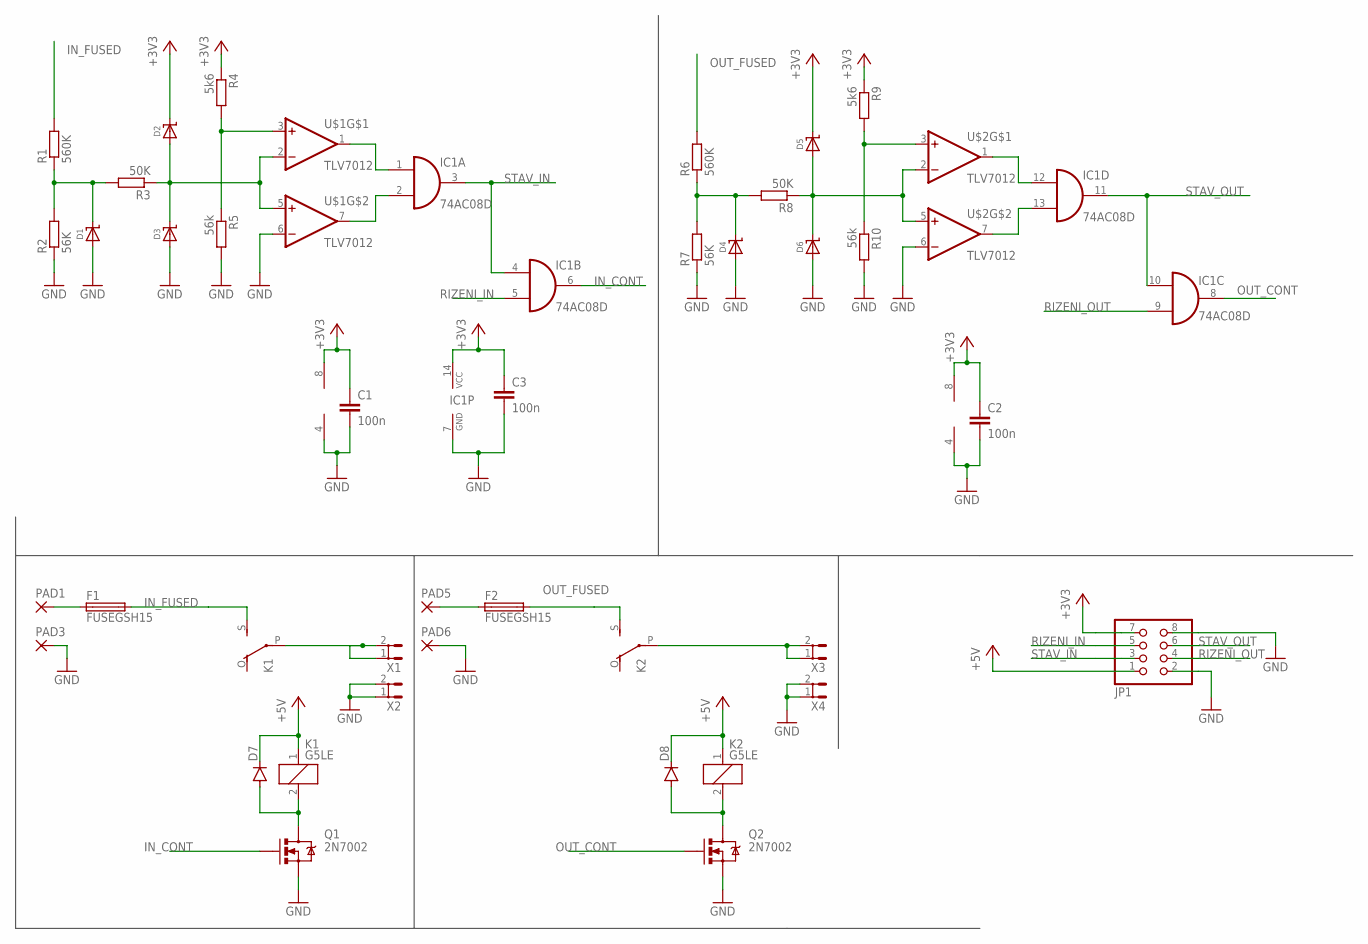
[picture p30: schematic BP_protection_board.sch]

Parts:
C1, C2, C3: 100n; C0805
D1, D2, D3, D4, D5, D6: DIODE-SCHOTTKYSOD-123; SOD-123
D7, D8: DIODE-MELF-MLL41; MELF-MLL41
F1, F2: FUSEGSH15; GSH15
IC1: 74AC08D; SO14
JP1: PINHD-2X4; 2X04
K1, K2: G5LE
PAD1, PAD3, PAD5, PAD6: 2,54/1,0
Q1, Q2: 2N7002; SOT323
R1, R6: 560K; R0805
R2, R7: 56K; R0805
R3, R8: 50K; R0805
R4, R9: 5k6; R0805
R5, R10: 56k; R0805
U$1, U$2: TLV7012; SOT-23-THIN
X1, X2, X3, X4: ST6,3

Connections:
+3V3: C1.1, C2.1, C3.1, D2.C, D5.C, IC1.14 (VCC), JP1.7, R4.1, R9.1, U$1.8 (V+), U$2.8 (V+)
+5V: D7.C, D8.C, JP1.1, K1.1, K2.1
GND: C1.2, C2.2, C3.2, D1.A, D3.A, D4.A, D6.A, IC1.7 (GND), JP1.2, JP1.8, PAD3.1, PAD6.1, Q1.2 (S), Q2.2 (S), R2.1, R5.2, R7.1, R10.2, U$1.4 (V-), U$1.6 (-IN), U$2.4 (V-), U$2.6 (-IN), X2.1, X2.2, X4.1, X4.2
IN_CONT: IC1.6 (O), Q1.1 (G)
IN_FUSED: F1.2, K1.S, R1.2
unnamed: D1.C, R1.1, R2.2, R3.2
unnamed: D2.A, D3.C, R3.1, U$1.2 (-IN), U$1.5 (+IN)
unnamed: R4.2, R5.1, U$1.3 (+IN)
unnamed: D4.C, R6.1, R7.2, R8.2
unnamed: F1.1, PAD1.1
unnamed: D5.A, D6.C, R8.1, U$2.2 (-IN), U$2.5 (+IN)
unnamed: R9.2, R10.1, U$2.3 (+IN)
unnamed: K1.P, X1.1, X1.2
unnamed: K2.P, X3.1, X3.2
unnamed: D8.A, K2.2, Q2.3 (D)
unnamed: D7.A, K1.2, Q1.3 (D)
unnamed: IC1.1 (I0), U$1.1 (OUT)
unnamed: IC1.2 (I1), U$1.7 (OUT)
unnamed: F2.1, PAD5.1
unnamed: IC1.12 (I0), U$2.1 (OUT)
unnamed: IC1.13 (I1), U$2.7 (OUT)
OUT_CONT: IC1.8 (O), Q2.1 (G)
OUT_FUSED: F2.2, K2.S, R6.2
RIZENI_IN: IC1.5 (I1), JP1.5
RIZENI_OUT: IC1.9 (I0), JP1.4
STAV_IN: IC1.3 (O), IC1.4 (I0), JP1.3
STAV_OUT: IC1.10 (I1), IC1.11 (O), JP1.6

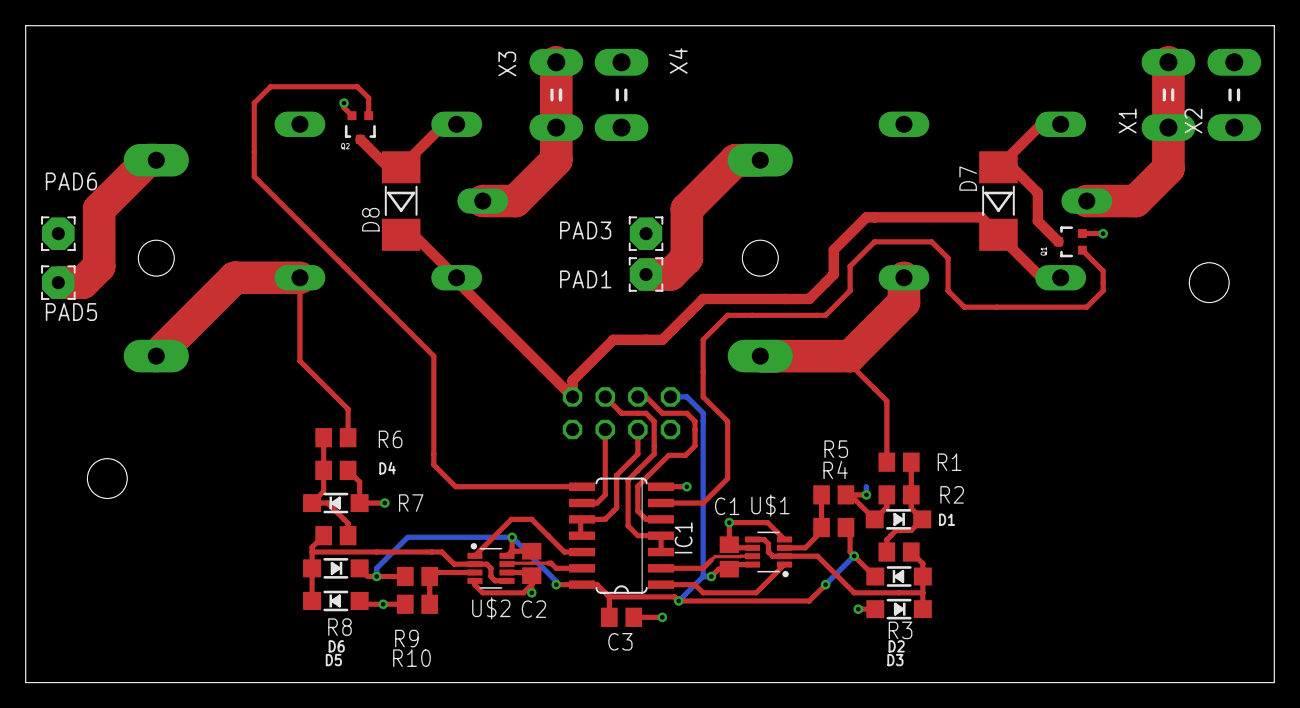
[picture p31: board BP_protection_board.brd from above]

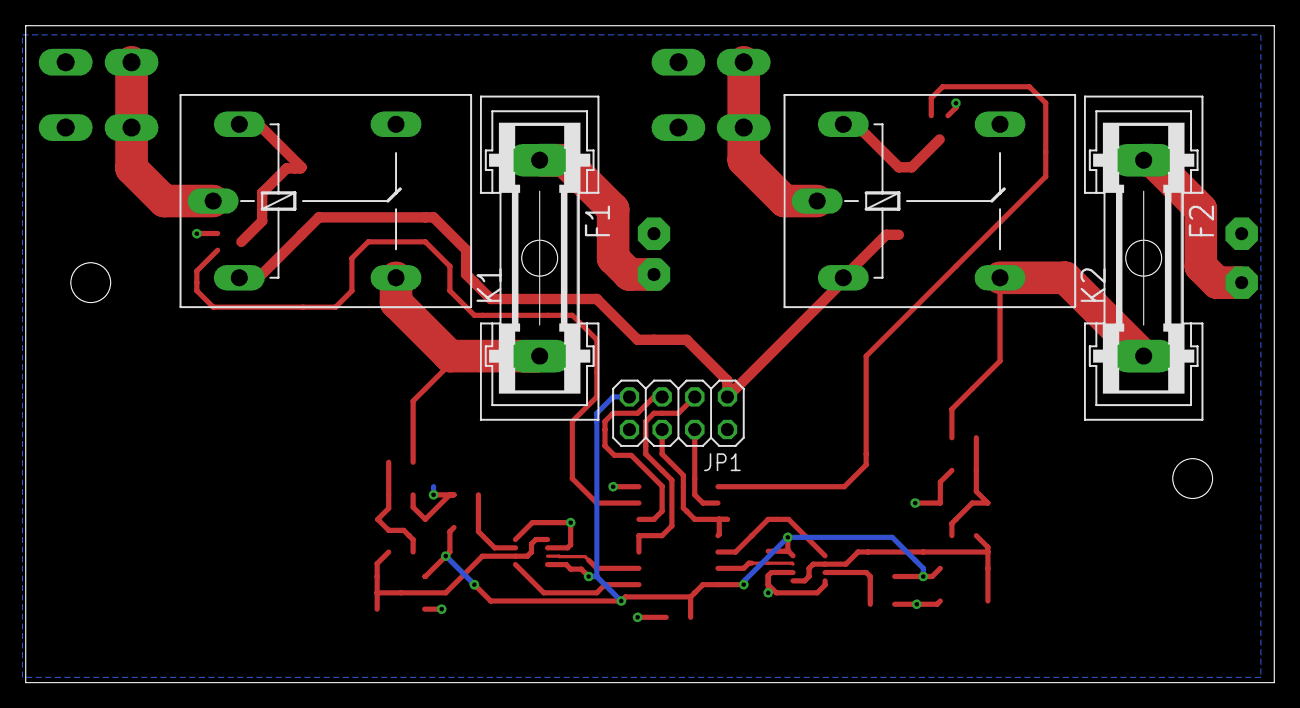
[picture p32: board BP_protection_board.brd from below]

Board: 2 copper layers, 97.1 x 51.1 mm, 39 parts (5 on the bottom side), 27 nets.
