Milan2mecha/mereni_efektivity/HW/BP_MCU.brd

## EAGLE design HW/BP_MCU.brd (2024-12-08)

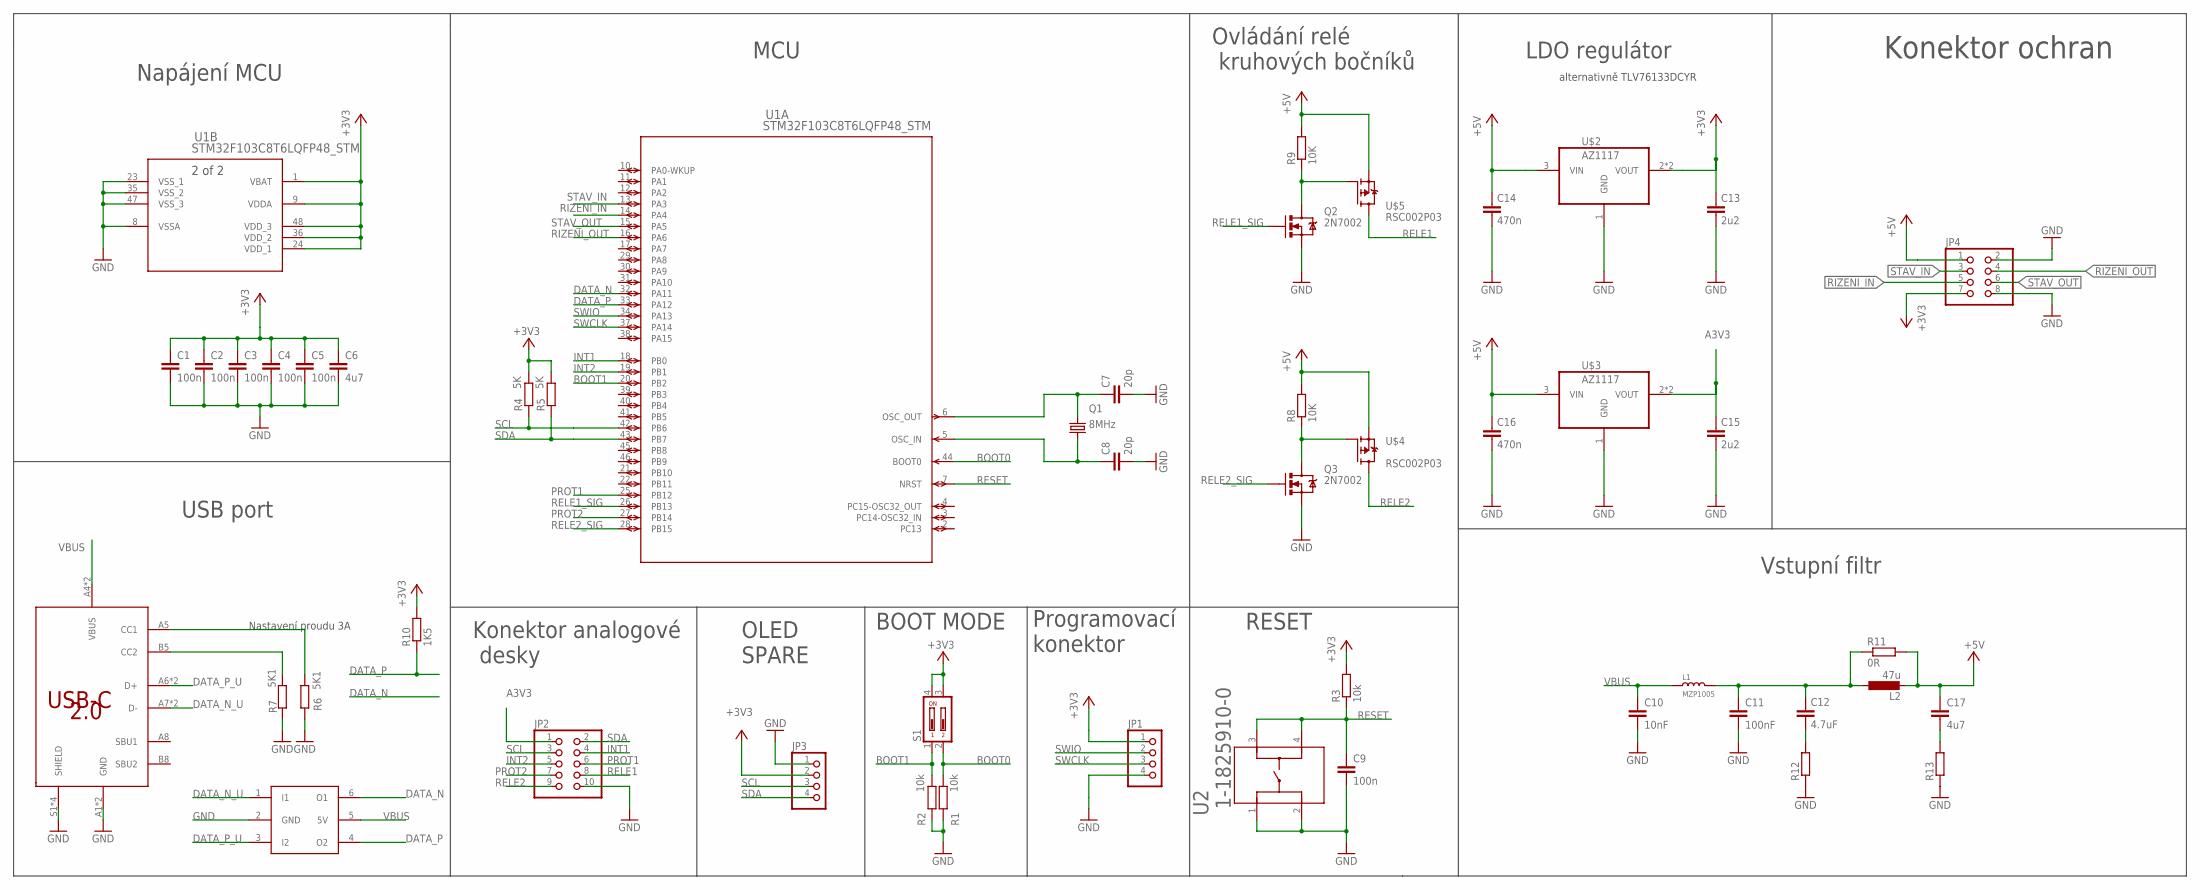
[picture p33: schematic BP_MCU.sch]

Parts:
C1, C2, C3, C4, C5, C9: 100n; C0805
C6, C17: 4u7; C0805
C7, C8: 20p; C0805
C10: 10nF; C0805
C11: 100nF; C0805
C12: 4.7uF; C0805
C13, C15: 2u2; C0805
C14, C16: 470n; C0805
JP1, JP3: PINHD-1X4; 1X04
JP2: PINHD-2X5; 2X05
JP4: PINHD-2X4; 2X04
L1: MZP1005; INDUCTOR_L0402
L2: 47u; AMRM001
Q1: 8MHz; HC49UP
Q2, Q3: 2N7002; SOT323
R1, R2, R3: 10k; R0805
R4, R5: 5K; R0805
R6, R7: 5K1; R0805
R8, R9: 10K; R0805
R10: 1K5; R0805
R11: 0R; R0805
R12, R13: R-EU_R0805; R0805
S1: SD4-02
U1: STM32F103C8T6LQFP48_STM; LQFP48_STM
U2: 1-1825910-0; SWITCH_1-1825910-0
U$1: 217179-0001-USB-C; TYPEC16
U$2, U$3: AZ1117; SOT230P700X180-4N
U$4, U$5: RSC002P03; SOT95
U$6: USBLC6-2; SOT23-6L

Connections:
+3V3: C1.1, C2.1, C3.1, C4.1, C5.1, C6.1, C13.1, JP1.1, JP3.2, JP4.7, R3.2, R4.2, R5.2, R10.2, S1.3, S1.4, U1.1 (VBAT), U1.9 (VDDA), U1.24 (VDD_1), U1.36 (VDD_2), U1.48 (VDD_3), U$2.2 (VOUT), U$2.4 (VOUT)
+5V: C14.1, C16.1, C17.1, JP4.1, L2.P$2 (2), R8.2, R9.2, R11.2, U$2.3 (VIN), U$3.3 (VIN), U$4.1 (S), U$5.1 (S)
A3V3: C15.1, JP2.1, U$3.2 (VOUT), U$3.4 (VOUT)
BOOT0: R1.2, S1.2, U1.44 (BOOT0)
BOOT1: R2.2, S1.1, U1.20 (PB2)
DATA_N: U1.32 (PA11), U$6.6 (O1)
DATA_N_U: U$1.A7 (D-), U$1.B7 (D-), U$6.1 (I1)
DATA_P: R10.1, U1.33 (PA12), U$6.4 (O2)
DATA_P_U: U$1.A6 (D+), U$1.B6 (D+), U$6.3 (I2)
GND: C1.2, C2.2, C3.2, C4.2, C5.2, C6.2, C7.2, C8.2, C9.2, C10.2, C11.2, C13.2, C14.2, C15.2, C16.2, JP1.4, JP2.10, JP3.1, JP4.2, JP4.8, Q2.2 (S), Q3.2 (S), R1.1, R2.1, R6.2, R7.2, R12.1, R13.1, U1.8 (VSSA), U1.23 (VSS_1), U1.35 (VSS_2), U1.47 (VSS_3), U2.1, U2.2, U$1.A1 (GND), U$1.A12 (GND), U$1.S1 (SHIELD), U$1.S2 (SHIELD), U$1.S3 (SHIELD), U$1.S4 (SHIELD), U$2.1 (GND), U$3.1 (GND), U$6.2 (GND)
INT1: JP2.4, U1.18 (PB0)
INT2: JP2.5, U1.19 (PB1)
unnamed: Q2.3 (D), R9.1, U$5.2 (G)
unnamed: Q3.3 (D), R8.1, U$4.2 (G)
unnamed: R7.1, U$1.B5 (CC2)
unnamed: R6.1, U$1.A5 (CC1)
unnamed: C12.2, R12.2
unnamed: C11.1, C12.1, L1.2, L2.P$1 (1), R11.1
unnamed: C17.2, R13.2
OSC_N: C8.1, Q1.1, U1.5 (OSC_IN)
OSC_P: C7.1, Q1.2, U1.6 (OSC_OUT)
PROT1: JP2.6, U1.25 (PB12)
PROT2: JP2.7, U1.27 (PB14)
RELE1: JP2.8, U$5.3 (D)
RELE1_SIG: Q2.1 (G), U1.26 (PB13)
RELE2: JP2.9, U$4.3 (D)
RELE2_SIG: Q3.1 (G), U1.28 (PB15)
RESET: C9.1, R3.1, U1.7 (NRST), U2.3, U2.4
RIZENI_IN: JP4.5, U1.14 (PA4)
RIZENI_OUT: JP4.4, U1.16 (PA6)
SCL: JP2.3, JP3.3, R4.1, U1.42 (PB6)
SDA: JP2.2, JP3.4, R5.1, U1.43 (PB7)
STAV_IN: JP4.3, U1.13 (PA3)
STAV_OUT: JP4.6, U1.15 (PA5)
SWCLK: JP1.3, U1.37 (PA14)
SWIO: JP1.2, U1.34 (PA13)
VBUS: C10.1, L1.1, U$1.A4 (VBUS), U$1.A9 (VBUS), U$6.5 (5V)

Notes on the sheet:
Nastavení proudu 3A
LDO regulátor
alternativně TLV76133DCYR
Napájení MCU
USB port
MCU
Konektor analogové desky
OLED SPARE
BOOT MODE
Programovací konektor
RESET
Ovládání relé kruhových bočníků
Vstupní filtr
Konektor ochran

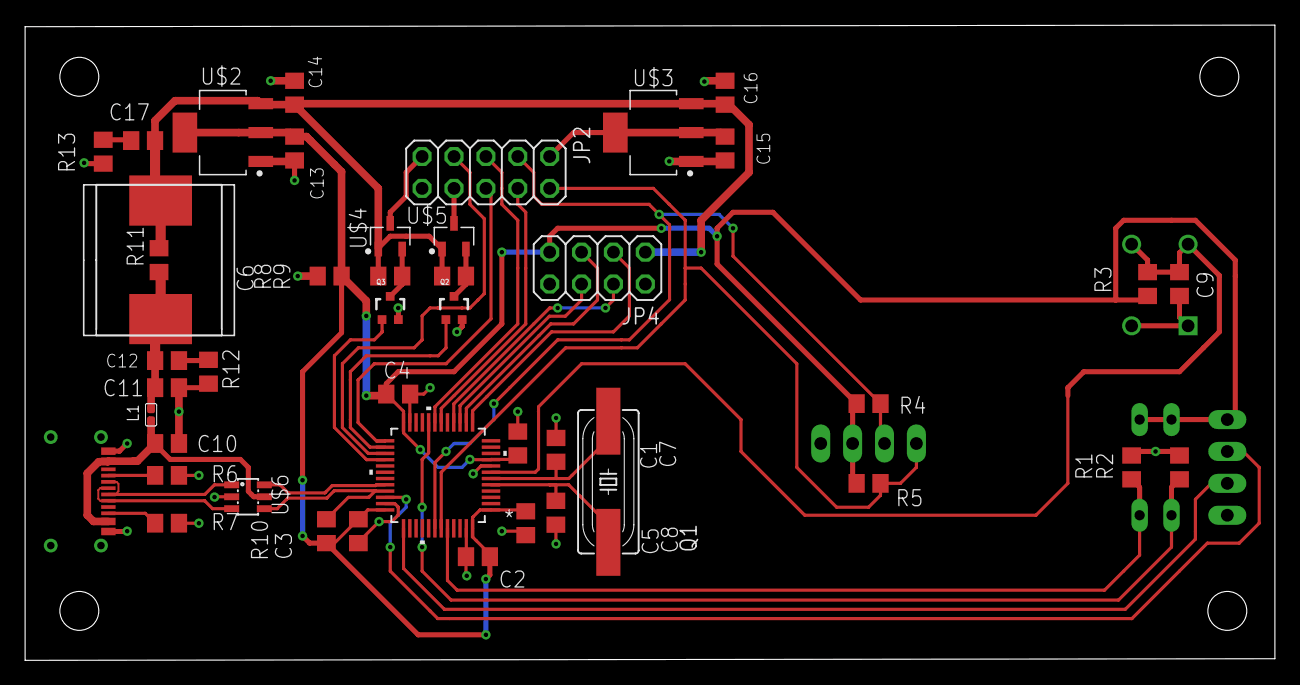
[picture p34: board BP_MCU.brd from above]

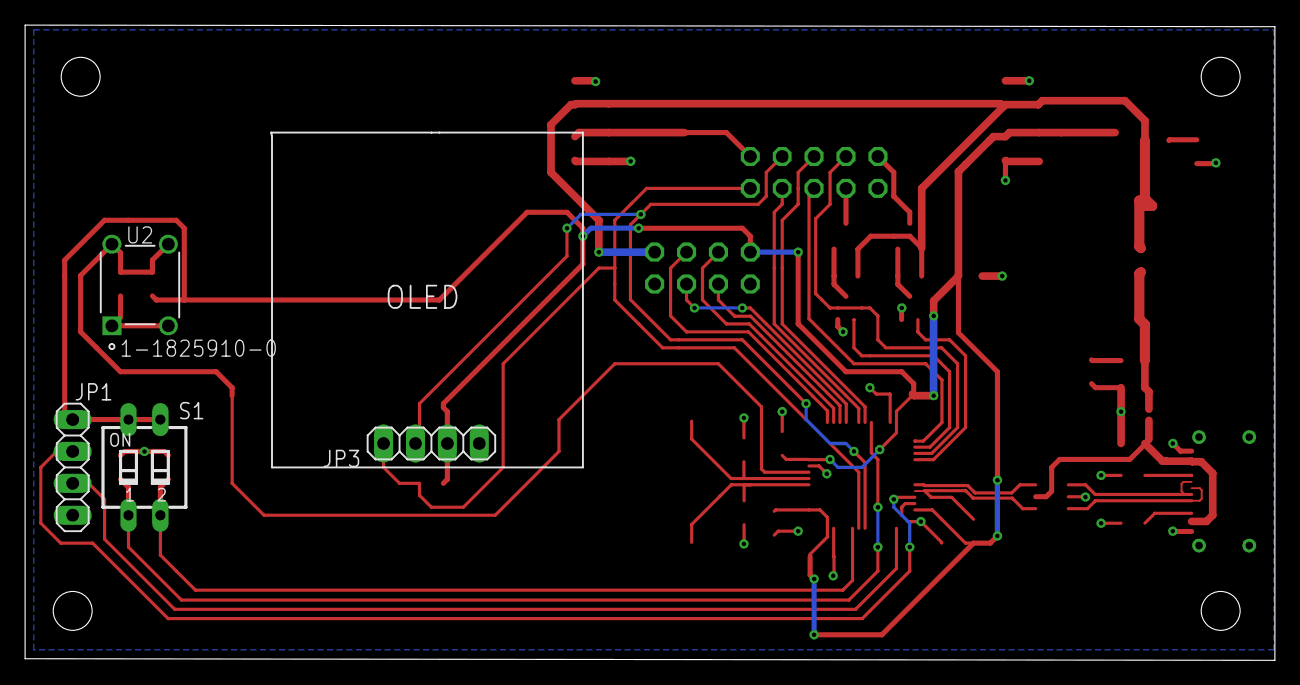
[picture p35: board BP_MCU.brd from below]

Board: 2 copper layers, 99.5 x 50.6 mm, 48 parts (4 on the bottom side), 37 nets.
