Milan2mecha/mereni_efektivity/HW/snimaci_cast.brd

## EAGLE design HW/snimaci_cast.brd (2024-12-08)

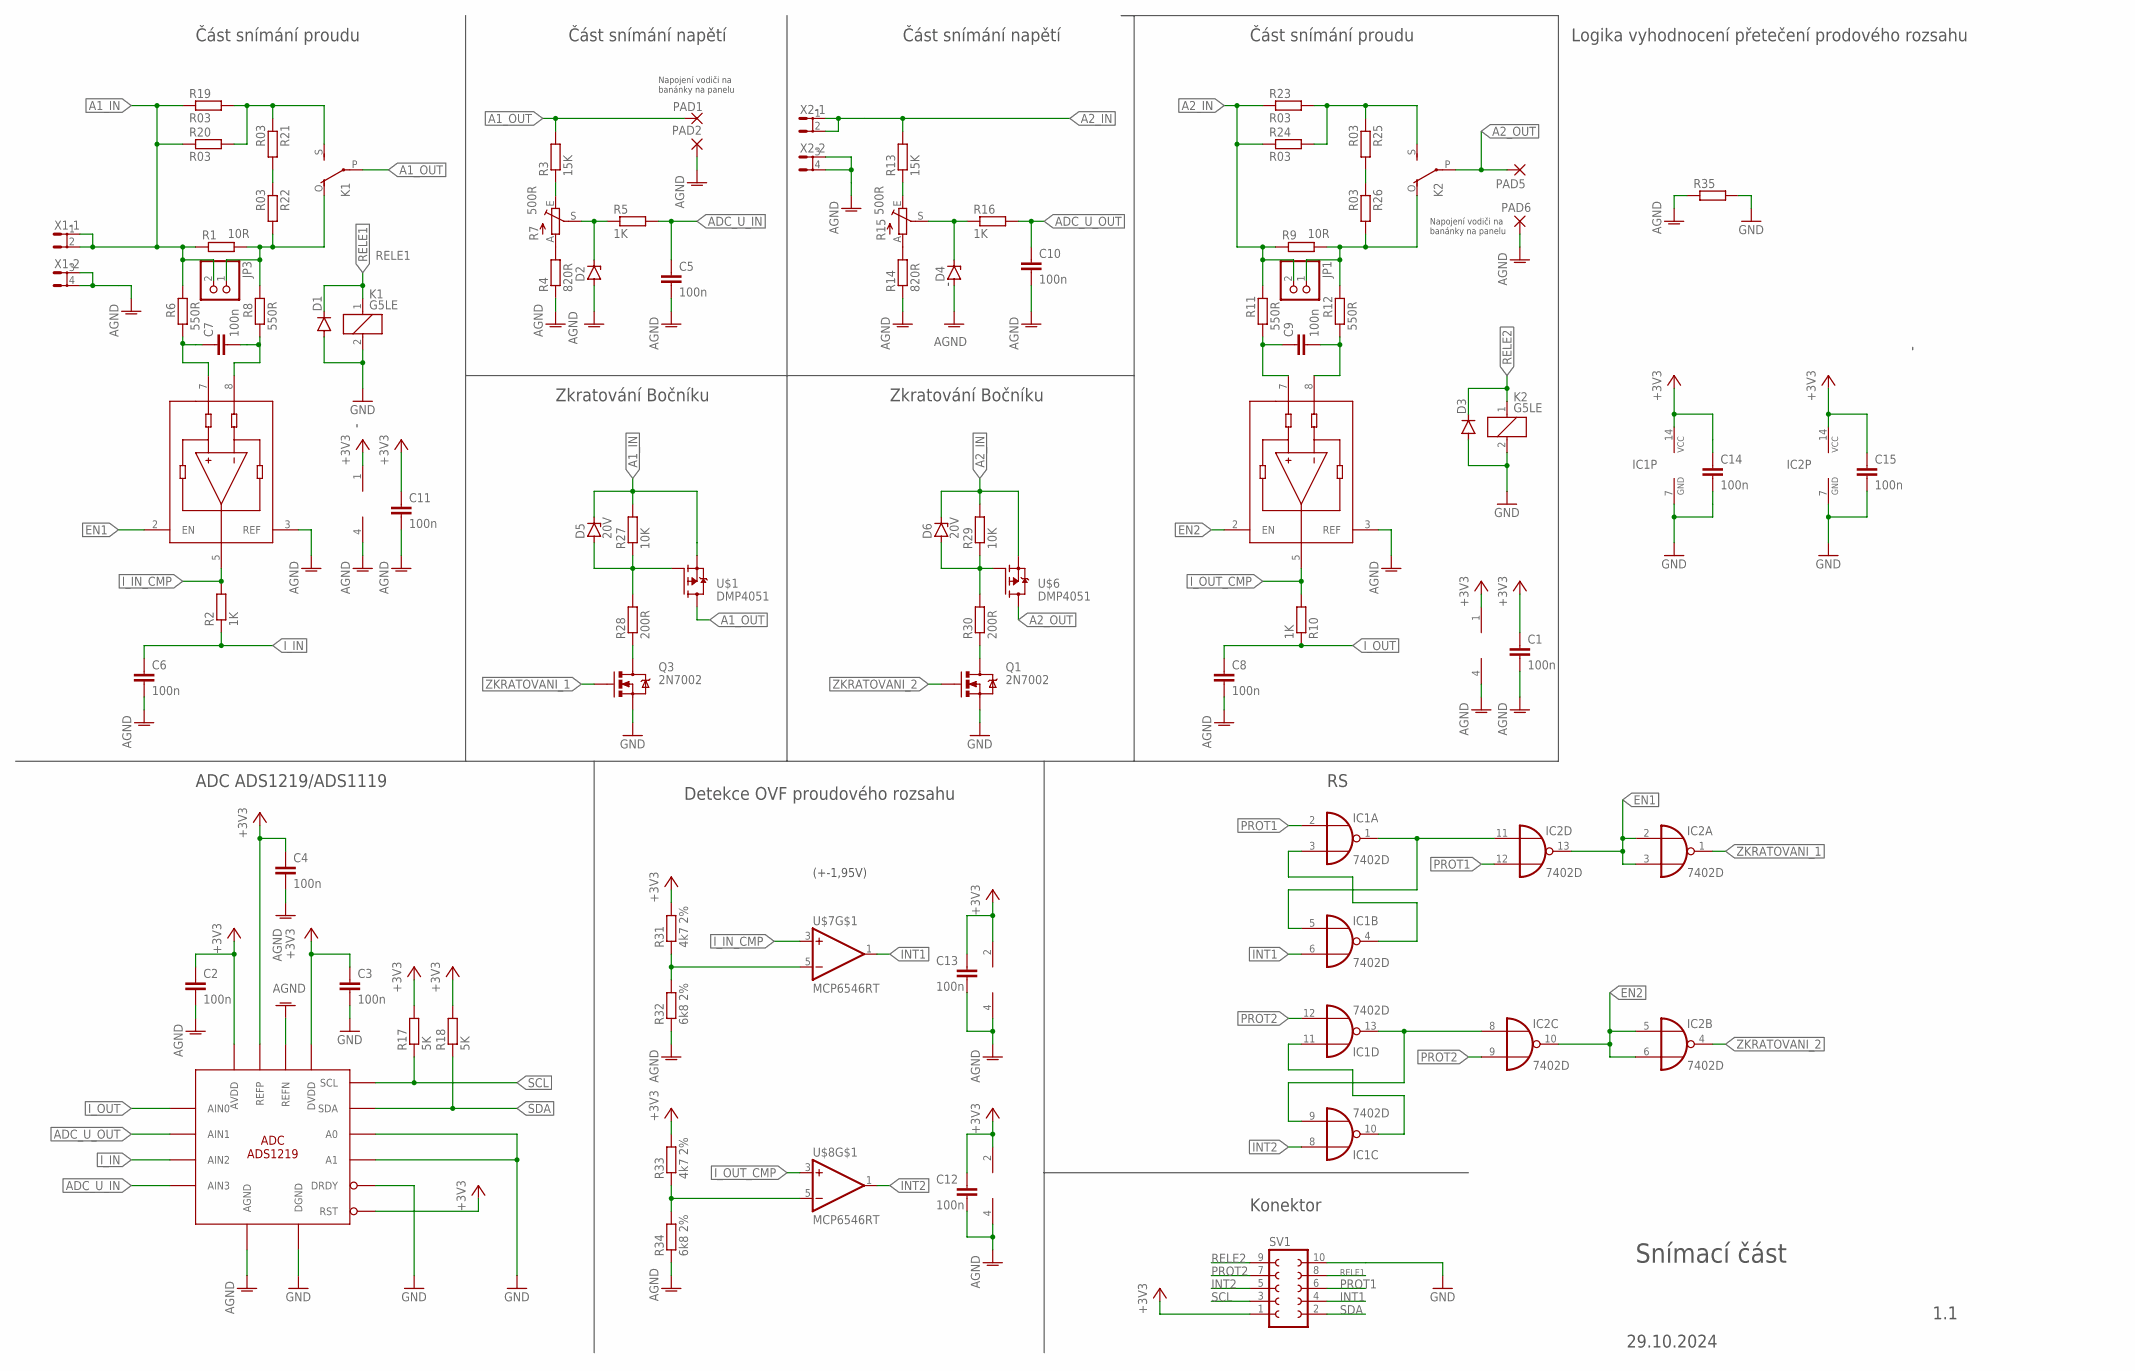
[picture p36: schematic snimaci_cast.sch]

Parts:
C1, C2, C3, C4, C5, C6, C7, C8, C9, C10, C11, C12, C13, C14, C15: 100n; C0805
D1, D3: DIODE-MELF-MLL41; MELF-MLL41
D2, D4: ZENER-DIODESOD80C; SOD80C
D5, D6: 20V; SMB
IC1, IC2: 7402D; SO14
JP1, JP3: PINHD-1X2; 1X02
K1, K2: G5LE
PAD1, PAD2, PAD5, PAD6: 2,15/1,0
Q1, Q3: 2N7002; SOT323
R1, R9: 10R; R1206
R2, R5, R10, R16: 1K; R0805
R3, R13: 15K; R0805
R4, R14: 820R; R0805
R6, R8, R11, R12: 550R; R0805
R7, R15: 500R; PT-10
R17, R18: 5K; R0805
R19, R20, R21, R22, R23, R24, R25, R26: R03; R1206
R27, R29: 10K; R0805
R28, R30: 200R; R0805
R31, R33: 4k7 2%; R0805
R32, R34: 6k8 2%; R0805
R35: R-EU_R0805; R0805
SV1: FE05-2
U$1, U$6: DMP4051; TO252
U$2: ADS1219; TSSOP16
U$4, U$5: INA190; SOT-23-THIN
U$7, U$8: MCP6546RT; SOT23-5
X1, X2: SH5-2

Connections:
+3V3: C1.1, C2.1, C3.1, C4.1, C11.1, C12.1, C13.1, C14.1, C15.1, IC1.14 (VCC), IC2.14 (VCC), R17.2, R18.2, R31.2, R33.2, SV1.1, U$2.3 (RST), U$2.9 (REFP), U$2.12 (AVDD), U$2.13 (DVDD), U$4.1 (V+), U$5.1 (V+), U$7.2 (V+), U$8.2 (V+)
A1_IN: D5.C, JP3.2, R1.1, R6.2, R19.1, R20.1, R27.2, U$1.2 (S), X1.1, X1.2
A1_OUT: K1.P, PAD1.1, R3.2, U$1.3 (D)
A2_IN: D6.C, JP1.2, R9.1, R11.2, R13.2, R23.1, R24.1, R29.2, U$6.2 (S), X2.1, X2.2
A2_OUT: K2.P, PAD5.1, U$6.3 (D)
ADC_U_IN: C5.1, R5.2, U$2.6 (AIN3)
ADC_U_OUT: C10.1, R16.2, U$2.10 (AIN1)
AGND: C1.2, C2.2, C4.2, C5.2, C6.2, C8.2, C10.2, C11.2, C12.2, C13.2, D2.A, D4.A, PAD2.1, PAD6.1, R4.1, R14.1, R32.1, R34.1, R35.1, U$2.5 (AGND), U$2.8 (REFN), U$4.3 (REF), U$4.4 (V-), U$5.3 (REF), U$5.4 (V-), U$7.4 (V-), U$8.4 (V-), X1.3 (1), X1.4 (2), X2.3 (1), X2.4 (2)
EN1: IC2.2 (I0), IC2.3 (I1), IC2.13 (O), U$4.2 (EN)
EN2: IC2.5 (I0), IC2.6 (I1), IC2.10 (O), U$5.2 (EN)
GND: C3.2, C14.2, C15.2, D1.A, D3.A, IC1.7 (GND), IC2.7 (GND), K1.2, K2.2, Q1.2 (S), Q3.2 (S), R35.2, SV1.10, U$2.1 (A0), U$2.2 (A1), U$2.4 (DGND), U$2.14 (DRDY)
INT1: IC1.6 (I1), SV1.4, U$7.1 (OUT)
INT2: IC1.8 (I0), SV1.5, U$8.1 (OUT)
I_IN: C6.1, R2.1, U$2.7 (AIN2)
I_IN_CMP: R2.2, U$4.5, U$7.3 (+IN)
I_OUT: C8.1, R10.1, U$2.11 (AIN0)
I_OUT_CMP: R10.2, U$5.5, U$8.3 (+IN)
unnamed: JP3.1, K1.O, R1.2, R8.2, R22.2
unnamed: R3.1, R7.E
unnamed: R4.2, R7.A
unnamed: D2.C, R5.1, R7.S
unnamed: JP1.1, K2.O, R9.2, R12.2, R26.2
unnamed: C7.2, R8.1, U$4.8 (-)
unnamed: D5.A, R27.1, R28.2, U$1.1 (G)
unnamed: R31.1, R32.2, U$7.5 (-IN)
unnamed: Q3.3 (D), R28.1
unnamed: D6.A, R29.1, R30.2, U$6.1 (G)
unnamed: R13.1, R15.E
unnamed: R14.2, R15.A
unnamed: D4.C, R15.S, R16.1
unnamed: K1.S, R19.2, R20.2, R21.1
unnamed: Q1.3 (D), R30.1
unnamed: C7.1, R6.1, U$4.7 (+)
unnamed: R21.2, R22.1
unnamed: R33.1, R34.2, U$8.5 (-IN)
unnamed: K2.S, R23.2, R24.2, R25.1
unnamed: R25.2, R26.1
unnamed: IC1.3 (I1), IC1.4 (O)
unnamed: IC1.10 (O), IC1.11 (I0)
OUT_N: C9.1, R11.1, U$5.7 (+)
OUT_P: C9.2, R12.1, U$5.8 (-)
PROT1: IC1.2 (I0), IC2.12 (I1), SV1.6
PROT2: IC1.12 (I1), IC2.9 (I1), SV1.7
Q_1: IC1.1 (O), IC1.5 (I0), IC2.11 (I0)
Q_2: IC1.9 (I1), IC1.13 (O), IC2.8 (I0)
RELE1: D1.C, K1.1, SV1.8
RELE2: D3.C, K2.1, SV1.9
SCL: R17.1, SV1.3, U$2.16 (SCL)
SDA: R18.1, SV1.2, U$2.15 (SDA)
ZKRATOVANI_1: IC2.1 (O), Q3.1 (G)
ZKRATOVANI_2: IC2.4 (O), Q1.1 (G)

Notes on the sheet:
Část snímání proudu
Část snímání napětí
Napojení vodiči na banánky na panelu
Konektor
Detekce OVF proudového rozsahu
(+-1,95V)
Snímací část
29.10.2024
1.1
Zkratování Bočníku
Logika vyhodnocení přetečení prodového rozsahu
ADC ADS1219/ADS1119

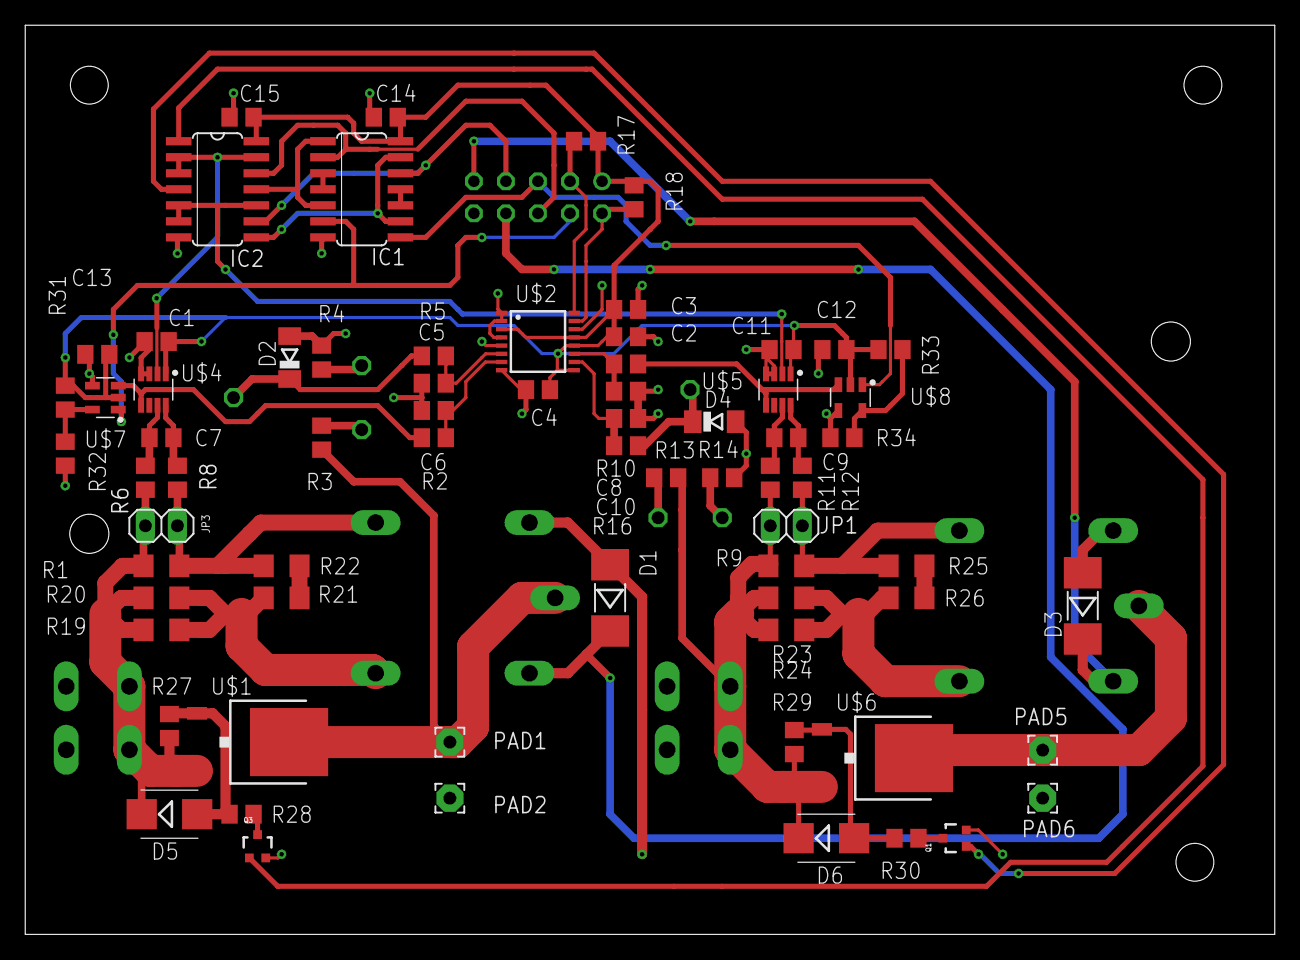
[picture p37: board snimaci_cast.brd from above]

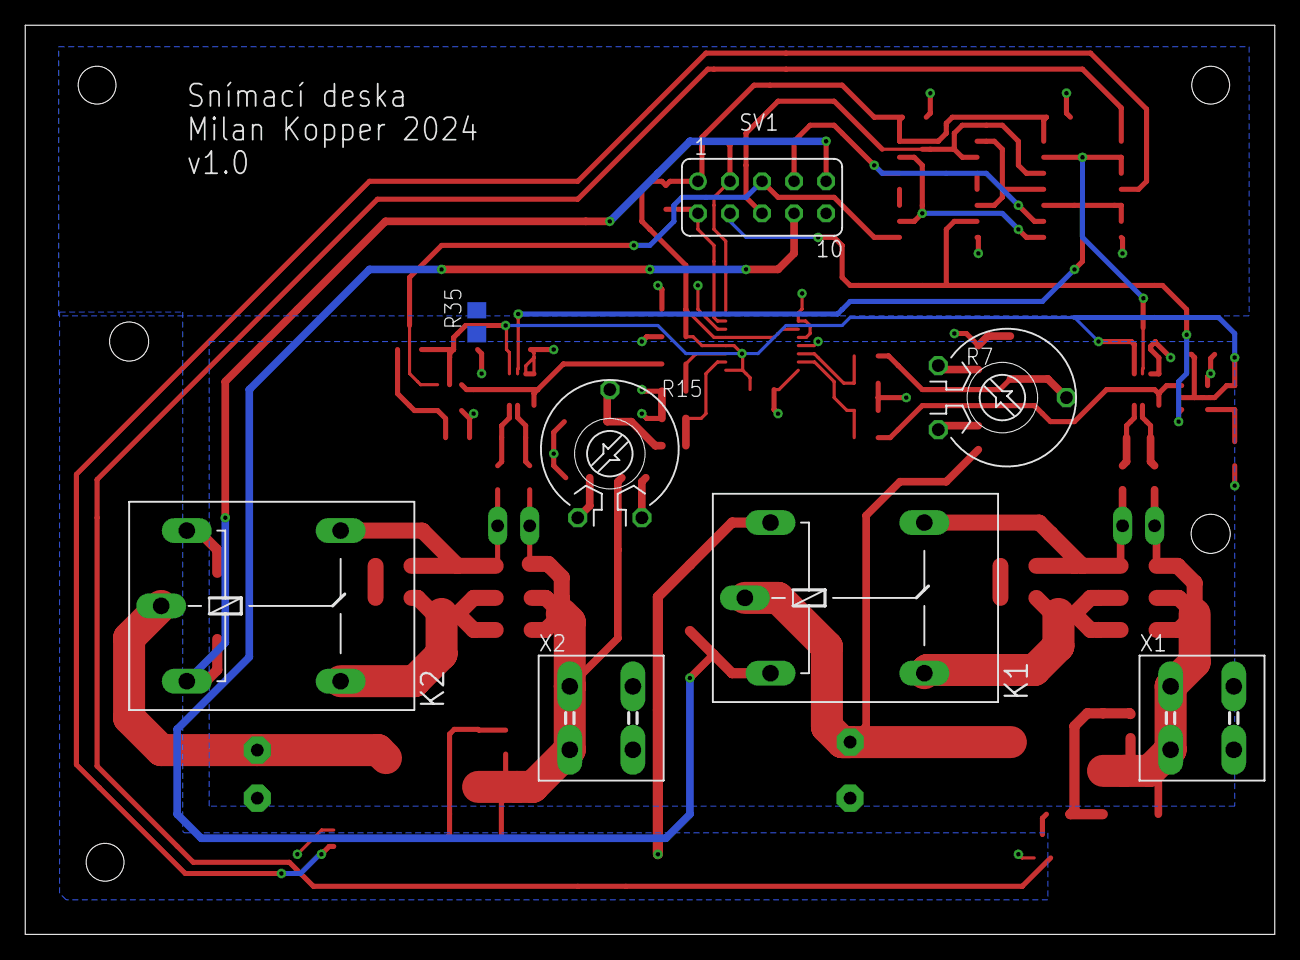
[picture p38: board snimaci_cast.brd from below]

Board: 2 copper layers, 99.0 x 72.1 mm, 78 parts (8 on the bottom side), 51 nets.
