Milan2mecha/mereni_efektivity/HW/BP_devboard.brd

## EAGLE design HW/BP_devboard.brd (2024-10-19)

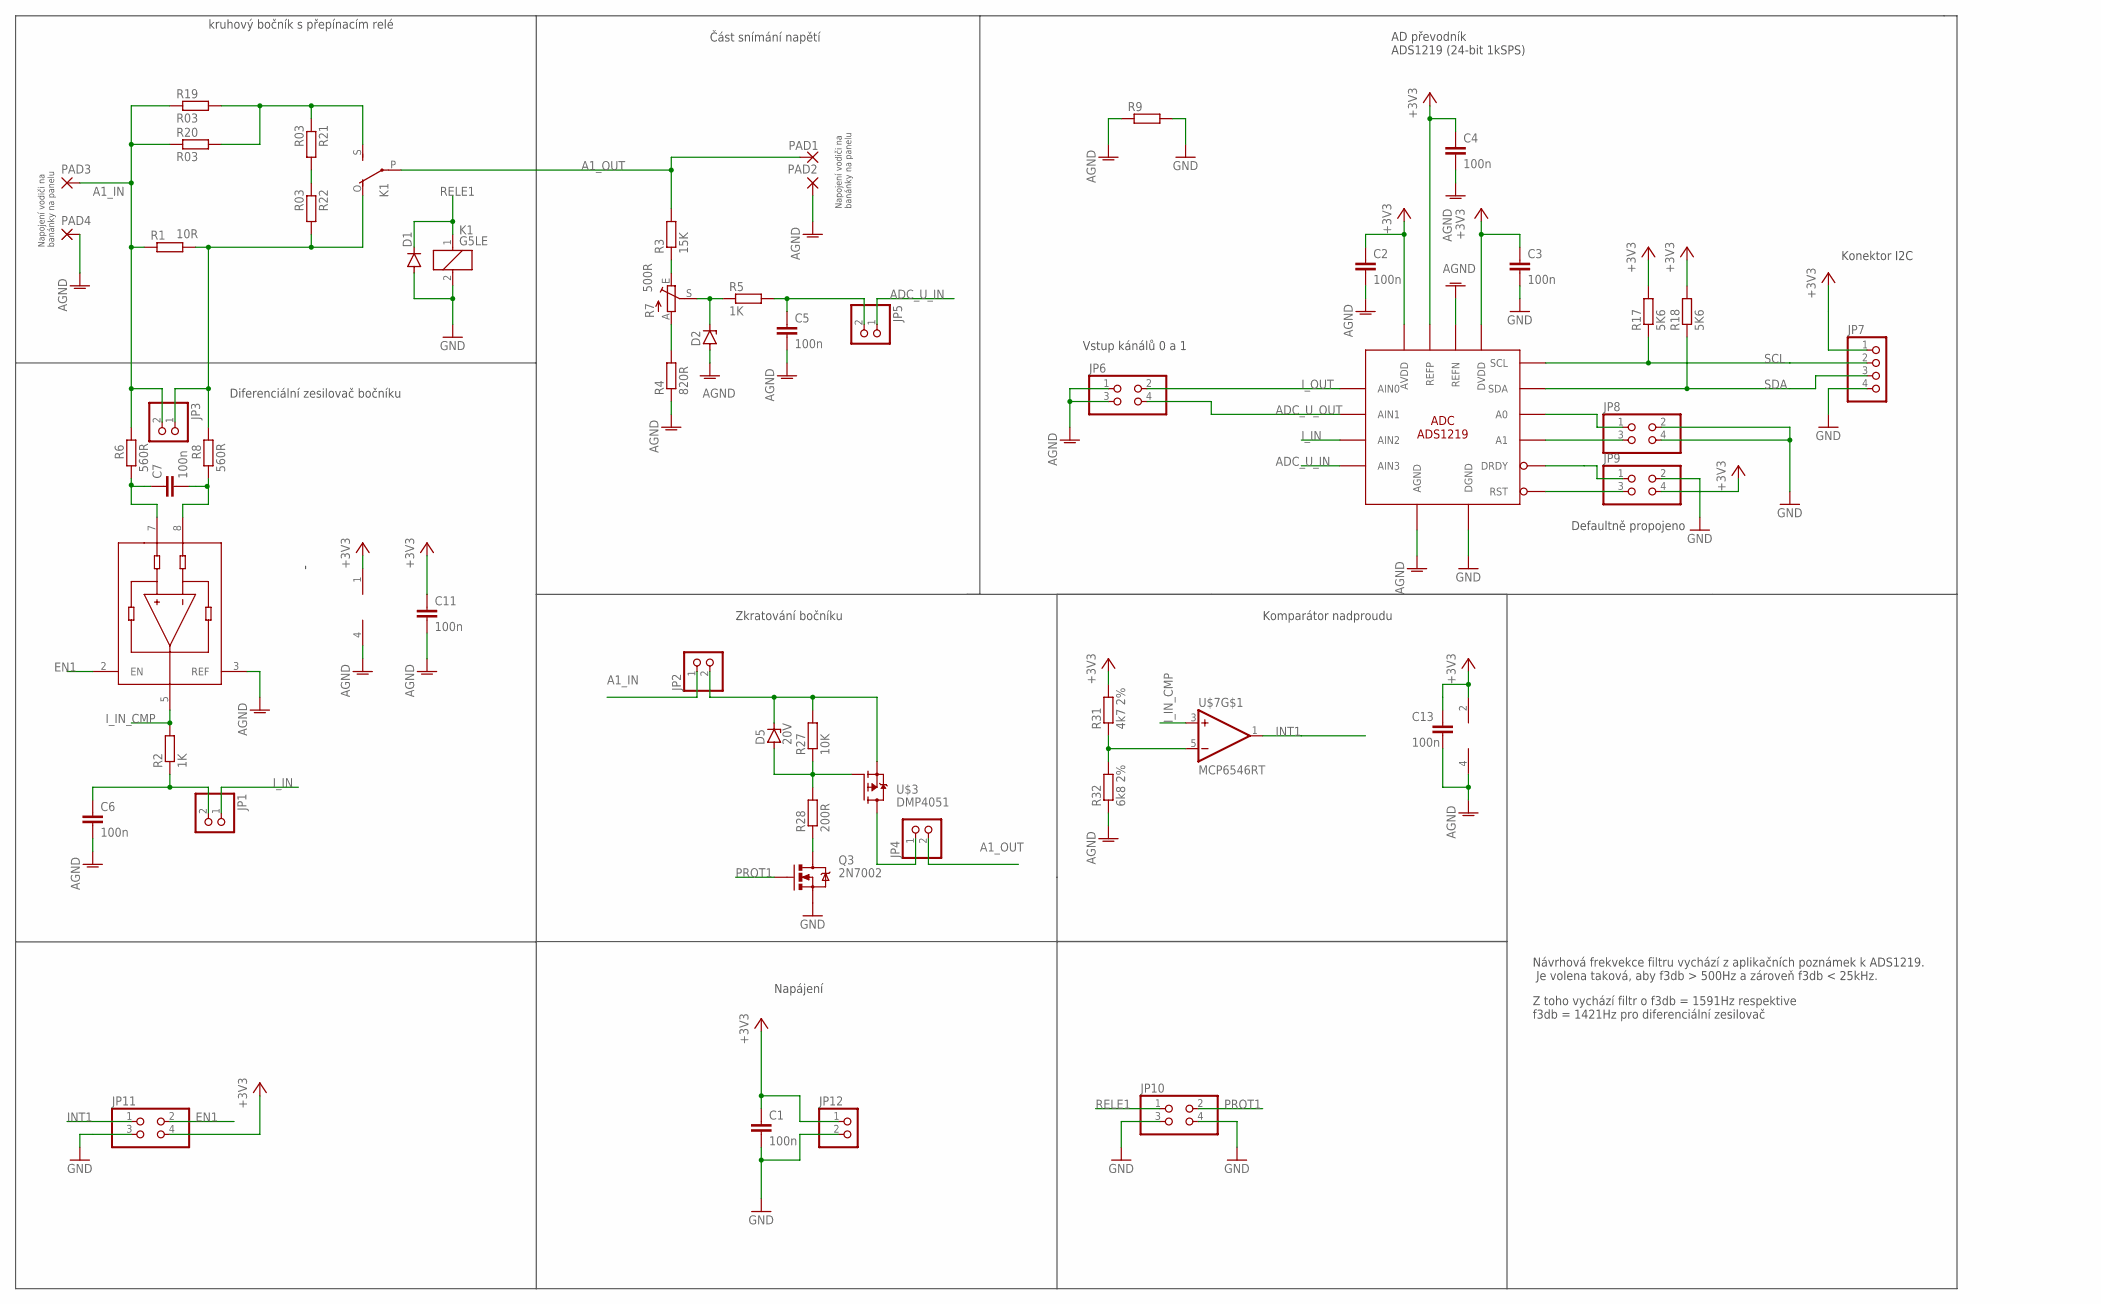
[picture p39: schematic BP_devboard.sch]

Parts:
C1, C2, C3, C4, C5, C6, C7, C11, C13: 100n; C0805
D1: DIODE-MELF-MLL41; MELF-MLL41
D2: ZENER-DIODESOD80C; SOD80C
D5: 20V; SMB
JP1, JP2, JP3, JP4, JP5, JP12: PINHD-1X2; 1X02
JP6, JP8, JP9, JP10, JP11: PINHD-2X2; 2X02
JP7: PINHD-1X4; 1X04
K1: G5LE
PAD1, PAD2, PAD3, PAD4: 2,15/1,0
Q3: 2N7002; SOT323
R1: 10R; R1206
R2, R5: 1K; R0805
R3: 15K; R0805
R4: 820R; R0805
R6, R8: 560R; R0805
R7: 500R; PT-10
R9: R-EU_R0805; R0805
R17, R18: 5K6; R0805
R19, R20, R21, R22: R03; R1206
R27: 10K; R0805
R28: 200R; R0805
R31: 4k7 2%; R0805
R32: 6k8 2%; R0805
U$2: ADS1219; TSSOP16
U$3: DMP4051; TO252
U$4: INA190; SOT-23-THIN
U$7: MCP6546RT; SOT23-5

Connections:
+3V3: C1.1, C2.1, C3.1, C4.1, C11.1, C13.1, JP7.1, JP9.4, JP11.4, JP12.1, R17.2, R18.2, R31.2, U$2.9 (REFP), U$2.12 (AVDD), U$2.13 (DVDD), U$4.1 (V+), U$7.2 (V+)
A1: JP8.3, U$2.2 (A1)
A1_IN: JP2.1, JP3.2, PAD3.1, R1.1, R6.2, R19.1, R20.1
A1_OUT: JP4.2, K1.P, PAD1.1, R3.2
ADC_U_IN: JP5.1, U$2.6 (AIN3)
ADC_U_OUT: JP6.4, U$2.10 (AIN1)
AGND: C2.2, C4.2, C5.2, C6.2, C11.2, C13.2, D2.A, JP6.1, JP6.3, PAD2.1, PAD4.1, R4.1, R9.1, R32.1, U$2.5 (AGND), U$2.8 (REFN), U$4.3 (REF), U$4.4 (V-), U$7.4 (V-)
EN1: JP11.2, U$4.2 (EN)
GND: C1.2, C3.2, D1.A, JP7.4, JP8.2, JP8.4, JP9.2, JP10.3, JP10.4, JP11.3, JP12.2, K1.2, Q3.2 (S), R9.2, U$2.4 (DGND)
INT1: JP11.1, U$7.1 (OUT)
I_IN: JP1.1, U$2.7 (AIN2)
I_IN_CMP: R2.2, U$4.5, U$7.3 (+IN)
I_OUT: JP6.2, U$2.11 (AIN0)
unnamed: JP3.1, K1.O, R1.2, R8.2, R22.2
unnamed: R3.1, R7.E
unnamed: R4.2, R7.A
unnamed: C6.1, JP1.2, R2.1
unnamed: D2.C, R5.1, R7.S
unnamed: JP4.1, U$3.3 (D)
unnamed: C7.2, R8.1, U$4.8 (-)
unnamed: D5.C, JP2.2, R27.2, U$3.2 (S)
unnamed: D5.A, R27.1, R28.2, U$3.1 (G)
unnamed: C5.1, JP5.2, R5.2
unnamed: Q3.3 (D), R28.1
unnamed: JP8.1, U$2.1 (A0)
unnamed: JP9.1, U$2.14 (DRDY)
unnamed: JP9.3, U$2.3 (RST)
unnamed: K1.S, R19.2, R20.2, R21.1
unnamed: R31.1, R32.2, U$7.5 (-IN)
unnamed: C7.1, R6.1, U$4.7 (+)
unnamed: R21.2, R22.1
PROT1: JP10.2, Q3.1 (G)
RELE1: D1.C, JP10.1, K1.1
SCL: JP7.2, R17.1, U$2.16 (SCL)
SDA: JP7.3, R18.1, U$2.15 (SDA)

Notes on the sheet:
Část snímání napětí
Napojení vodiči na banánky na panelu
Napájení
AD převodník ADS1219 (24-bit 1kSPS)
Konektor I2C
Defaultně propojeno
Vstup kánálů 0 a 1
Komparátor nadproudu
Zkratování bočníku
kruhový bočník s přepínacím relé
Diferenciální zesilovač bočníku
Návrhová frekvekce filtru vychází z aplikačních poznámek k ADS1219. Je volena taková, aby f3db > 500Hz a zároveň f3db < 25kHz.
Z toho vychází filtr o f3db = 1591Hz respektive f3db = 1421Hz pro diferenciální zesilovač
