Milan2mecha/mereni_efektivity/HW/BP_devboard.brd

## EAGLE design HW/BP_devboard.brd (continued)

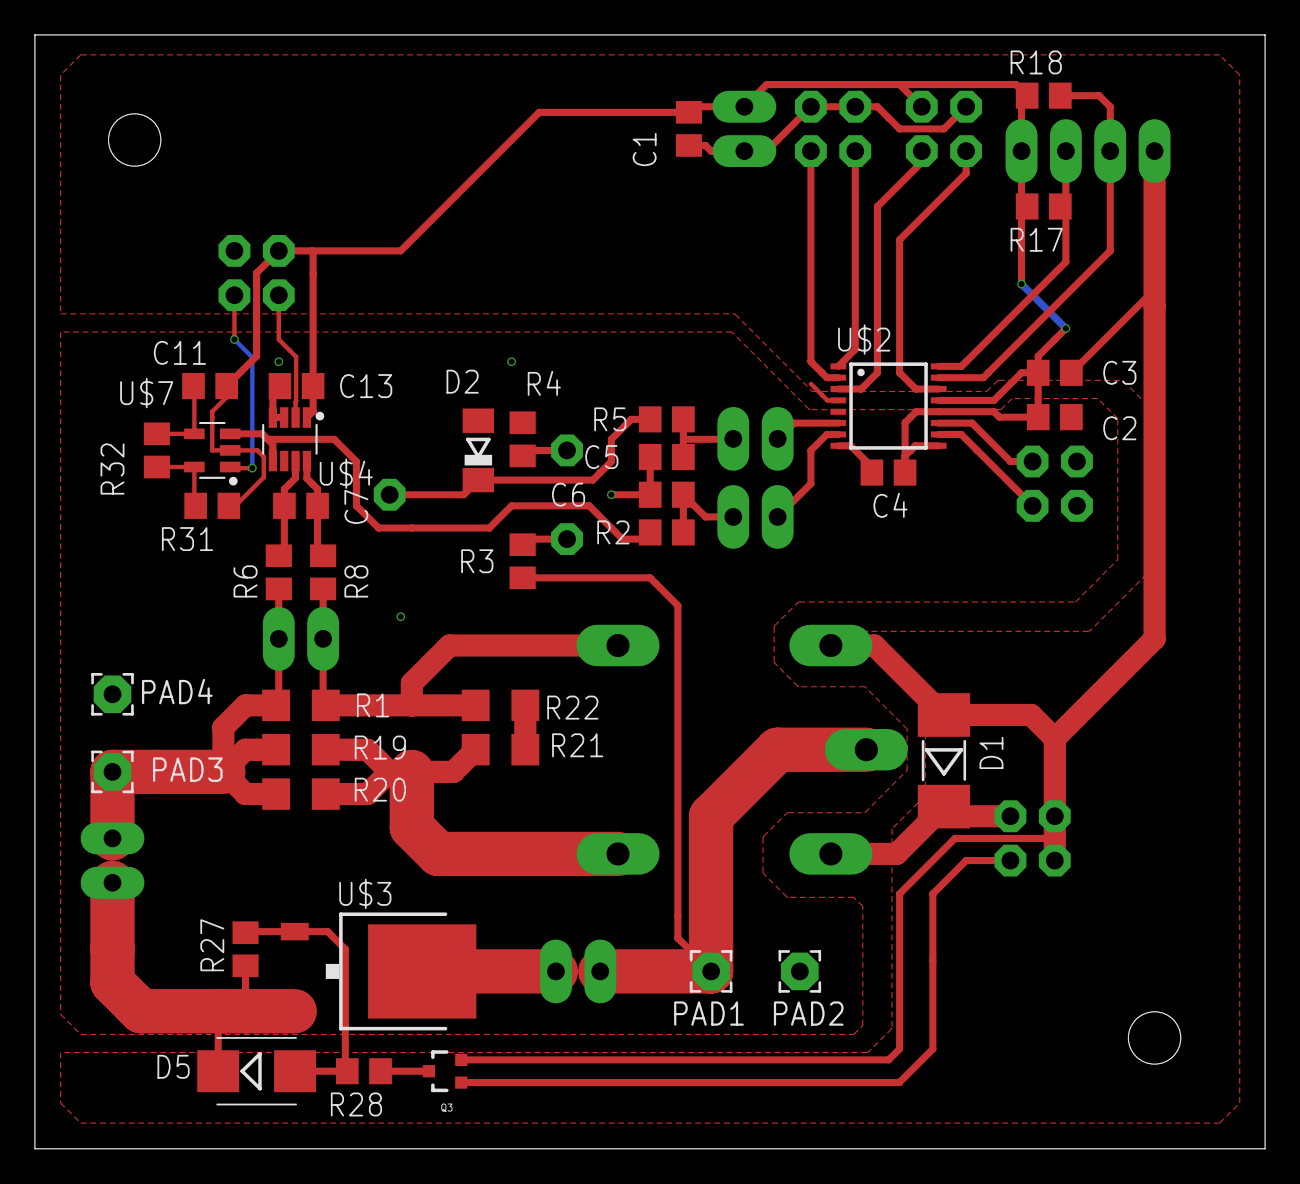
[picture p40: board BP_devboard.brd from above]

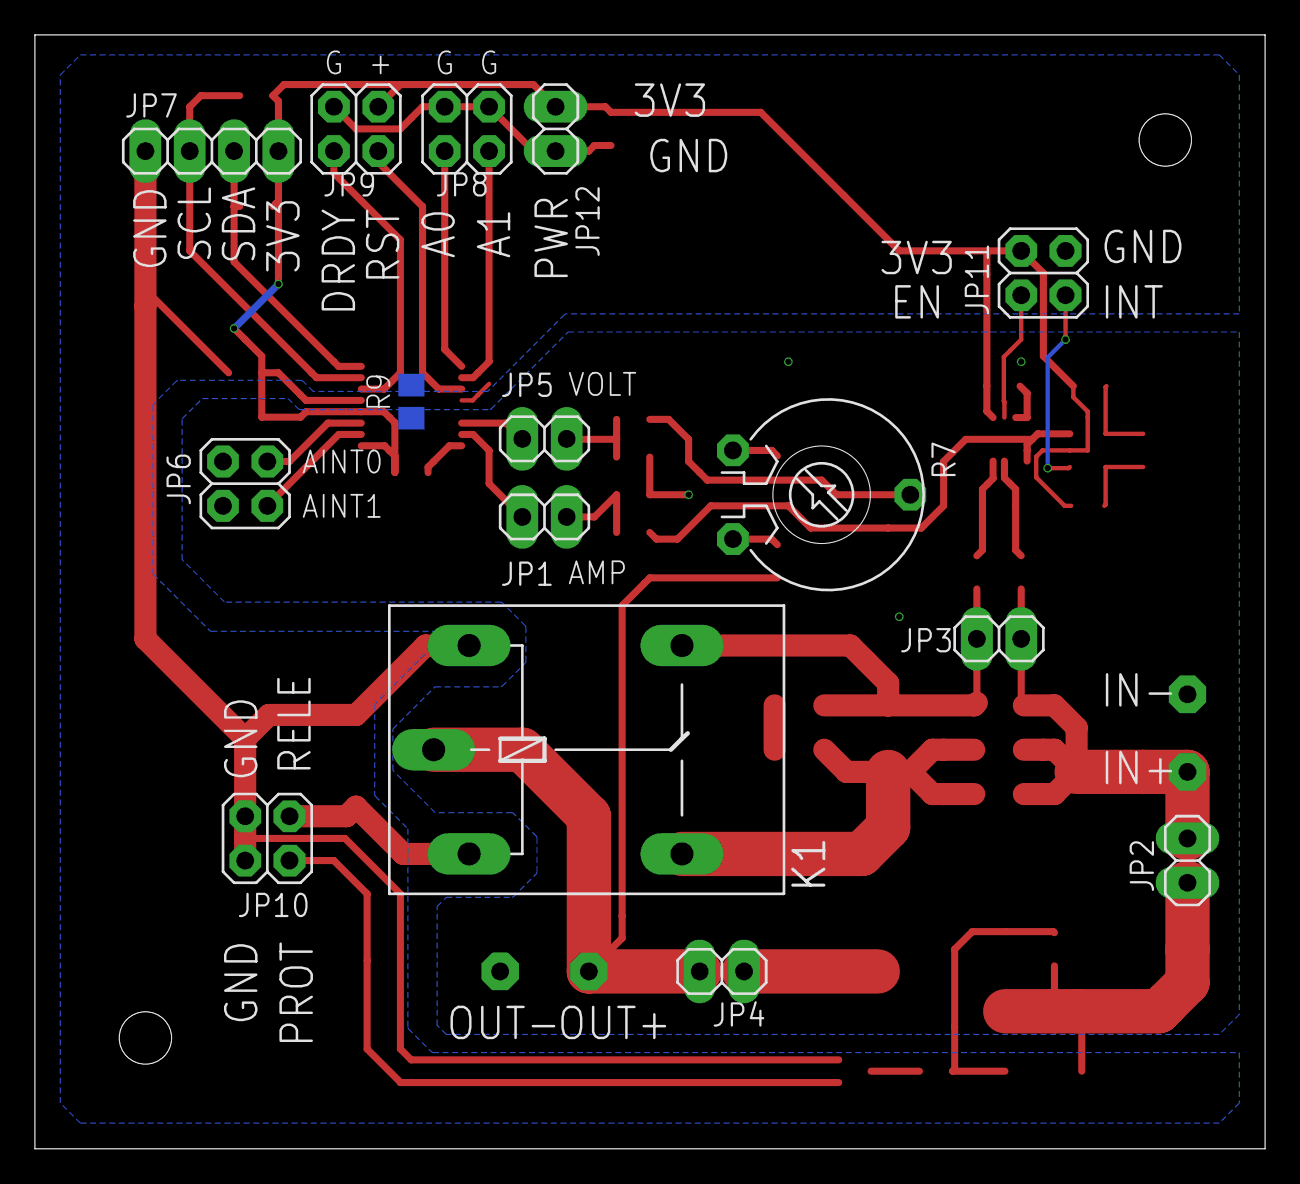
[picture p41: board BP_devboard.brd from below]

Board: 2 copper layers, 70.5 x 63.8 mm, 53 parts (15 on the bottom side), 35 nets.
