Milan2mecha/mereni_efektivity/FW_EFmeter/Core/Src/main.c

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
/* Includes ------------------------------------------------------------------*/
#include "main.h"
#include "i2c.h"
#include "tim.h"
#include "usb_device.h"
#include "gpio.h"

/* USER CODE BEGIN Includes */
#include "scpi/scpi.h"
#include "Display.h"
#include "HW_hand.h"
#include "DMM.h"
#include "scpi-def.h"
#include "eeprom.h"
#include "eeprom_loader.h"
/* USER CODE END Includes */


void SystemClock_Config(void);
/* USER CODE BEGIN 0 */
//Informace o příchozích datech v bufferu
extern uint8_t UserRxBufferFS[1000];
extern uint8_t is_new_data_ready;
extern uint16_t new_data_length;
//adresy ROM pro kostanty
const uint16_t VirtAddVarTab[NB_OF_VAR] =    {0x0000, 0x0001, 0x0002, 0x0003, 0x0004, 0x0005, 0x0006, 0x0007,
0x0008, 0x0009, 0x000A, 0x000B, 0x000C, 0x000D, 0x000E, 0x000F,
0x0010, 0x0011, 0x0012, 0x0013, 0x0014, 0x0015, 0x0016, 0x0017,
0x0018, 0x0019, 0x001A, 0x001B, 0x001C, 0x001D, 0x001E, 0x001F,
0x0020, 0x0021, 0x0022, 0x0023, 0x0024, 0x0025, 0x0026, 0x0027,
0x0028, 0x0029, 0x002A, 0x002B, 0x002C, 0x002D, 0x002E, 0x002F,
0x0030, 0x0031, 0x0032, 0x0033, 0x0034, 0x0035, 0x0036, 0x0037,
0x0038, 0x0039, 0x003A, 0x003B, 0x003C, 0x003D, 0x003E, 0x003F,
0x0040, 0x0041, 0x0042, 0x0043, 0x0044, 0x0045, 0x0046, 0x0047,
0x0048, 0x0049, 0x004A, 0x004B, 0x004C, 0x004D, 0x004E, 0x004F,
0x0050, 0x0051, 0x0052, 0x0053, 0x0054, 0x0055, 0x0056, 0x0057,
0x0058, 0x0059, 0x005A, 0x005B, 0x005C, 0x005D, 0x005E, 0x005F,
0x0060, 0x0061, 0x0062, 0x0063, 0x0064, 0x0065, 0x0066, 0x0067,
0x0068, 0x0069, 0x006A, 0x006B, 0x006C, 0x006D, 0x006E, 0x006F,
0x0070, 0x0071, 0x0072, 0x0073, 0x0074, 0x0075, 0x0076, 0x0077,
0x0078, 0x0079, 0x007A, 0x007B, 0x007C, 0x007D, 0x007E, 0x007F,
0x0080, 0x0081, 0x0082, 0x0083, 0x0084, 0x0085, 0x0086, 0x0087,
0x0088, 0x0089, 0x008A, 0x008B, 0x008C, 0x008D, 0x008E, 0x008F
};
//uint8_t last_ch = 0;
/* USER CODE END 0 */

/**
  * @brief  The application entry point.
  * @retval int
  */
int main(void)
{
  /* MCU Configuration--------------------------------------------------------*/

  /* Reset of all peripherals, Initializes the Flash interface and the Systick. */
  HAL_Init();

  /* Configure the system clock */
  SystemClock_Config();

  /* Initialize all configured peripherals */
  MX_GPIO_Init();
  MX_USB_DEVICE_Init();
  MX_I2C1_Init();
  MX_TIM1_Init();
  /* USER CODE BEGIN 2 */
  HAL_FLASH_Unlock();
  EE_Init();
  HAL_TIM_Base_Start(&htim1);
  HW_init();
  //DMM_Enable();
  DP_init();
  SCPI_Init(&scpi_context,
              scpi_commands,
              &scpi_interface,
              scpi_units_def,
              SCPI_IDN1, SCPI_IDN2, SCPI_IDN3, SCPI_IDN4,
              scpi_input_buffer, SCPI_INPUT_BUFFER_LENGTH,
              scpi_error_queue_data, SCPI_ERROR_QUEUE_SIZE);
  DrawSCPI();
  load_EEPROM();
  /* USER CODE END 2 */

  /* Infinite loop */
  /* USER CODE BEGIN WHILE */
  while (1)
  {
	    /*Přišla nová data*/
		  if(is_new_data_ready){
			  SCPI_Input(&scpi_context,(char*)UserRxBufferFS,  new_data_length);
			  is_new_data_ready = 0;
		  }
	/*Zkontroluje chybové stavy*/
      if(HW_status()){
        DMM_Disable();
      }

    /* USER CODE END WHILE */

    /* USER CODE BEGIN 3 */
  }
  /* USER CODE END 3 */
}

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
