Milan2mecha/mereni_efektivity/(commit log)

2024-10-13 Vytvoření schémat analogové a digitální části.
    [BP_MCU.sch, snimaci_cast.brd, snimaci_cast.sch]
2024-10-19 Úvodní návrh devboardu a návrh obvodů pro detekci přepolování a přepětí
    [BP_devboard.brd, BP_devboard.sch]
2024-10-27 Návrh desky ochran
    [BP_protection_board.brd, BP_protection_board.sch]
2024-10-29 Přidáno propojení desek fastony a distančními sloupky, změněna logika vyhodnocení nežádoucích stavů
    [BP_protection_board.brd, BP_protection_board.sch, snimaci_cast.brd, snimaci_cast.sch]
2024-11-03 Oprava knihovny pro ADC
2024-11-10 Vytvoření ovládací desky, simulace a úprava filtrů
    [BP_MCU.brd, BP_MCU.sch]
2024-12-08 Verze zadaná do výroby
    [BP_MCU.brd, BP_MCU.sch, BP_protection_board.brd, snimaci_cast.brd, snimaci_cast.sch]
2025-02-08 Přidání kostry FW v modifikaci pro provoz v konzoli
    [BP_MCU.sch, scpi.g]
2025-02-23 Přidání demo programů pro zobrazování na OLED a pro simulaci NI LabView
    [scpi.g]
2025-03-01 Zahájení prací na driveru pro LabView
2025-03-14 demo na F103CB s funkčním autorangem
    [scpi.g]
2025-03-23 Prodloužení přepínacích dob pro zvýšení stability
    [HW_hand.c]
2025-04-06 Odstranění starého dema
    [scpi.g]
2025-04-21 Opraveny funkce EEPROM, stále bez continous samplingu
    [test.csv]
2025-04-26 Vytvoření měřicího m´du pro DCIR
    [BP_MCU v23.csv, scpi.g]
2025-04-30 Přidání výsledků kalibračních měření
    [Iin_1A_5V_5A_5V_5x_multiply.csv, Iout_1A_5V.csv, Iout_5A_5V_5xmultiply.csv, MereniVIN1.csv, MereniVOUT1.csv]
2025-05-11 Úpravy LabVIEW
    [rozptyl.csv]
2025-05-14 Měření rozptylu 1A
    [rozptyl1A.csv]
2025-05-16 Opravena chyba FW + zpřehlednění
    [rozptyl5A.csv, scpi.g]
2025-05-16 Instrument driver obrázky
