Milan2mecha/mereni_efektivity/(notices)

Notices in the files:
FW_EFmeter/Core/Src/main.c:
Copyright (c) 2025 STMicroelectronics.
All rights reserved.
This software is licensed under terms that can be found in the LICENSE file
parts and their libraries:
2024-10-04_13-16-44_Library: COPYRIGHT: Copyright (C) 2024 Ultra Librarian. All rights reserved.
Switches: COPYRIGHT: Copyright (C) 2016 Accelerated Designs. All rights reserved
